CREPP-PLOEMEUR/le_Pot_Qui_pense/README.md

<!--# Le Pot Qui Pense -->
<!--+ 2019-2020 -->
<!--$ Jardinage-->
<!--$ Python -->
<!--% Un projet de plante connectée pour arroser automatiquement une plante. -->
# Pot Qui Pense

## Le projet 

Un projet de plante connectée pour arroser automatiquement une plante.

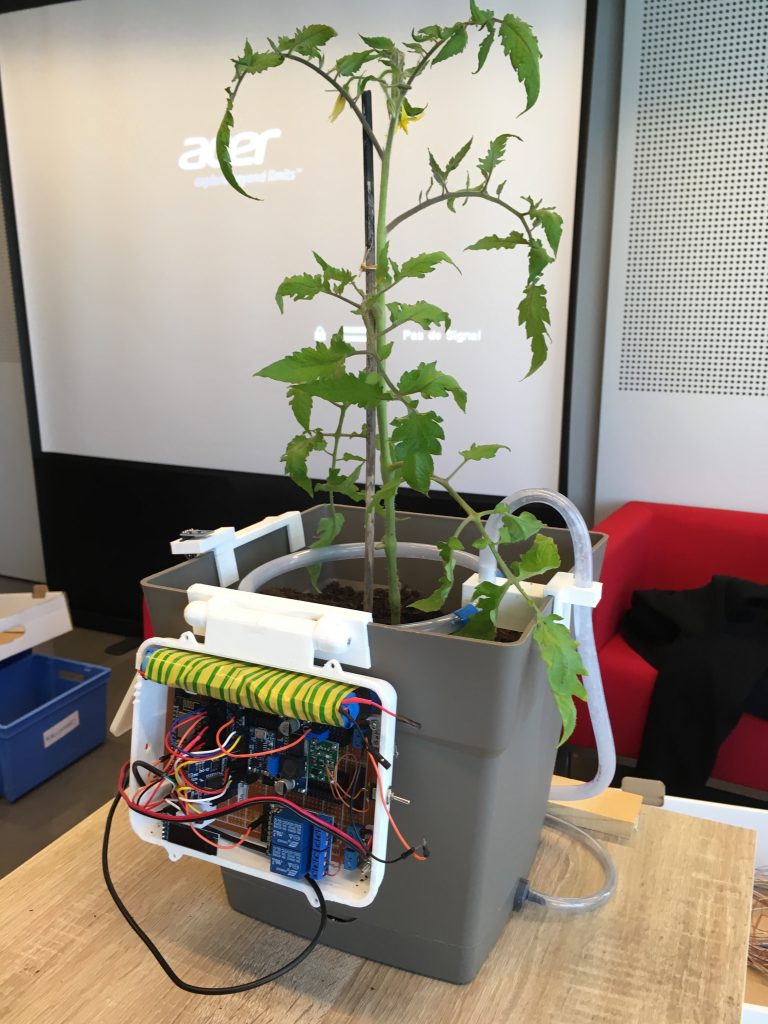
[picture p1: .img/pqp.jpg]
Pinout
