CREPP-PLOEMEUR/le_Pot_Qui_pense/Diagrammes/Essais PQP couvercle monté.odt

ESSAIS PQP ( couvercle monté – arrosage à 9h00 le matin )

L'objectif de ces essais est de :

- Sachant que l' écart entre U oled et U batteries est égal à 0.8, vérifier de 7h00 à 23h la valeur de la tension affichée,

- Mesurer à 23h00 la valeur de la tension aux bornes de la batterie,

- Vérifier à 7h00 la valeur de la tension affichée et mesurer la tension batteries,

- Voir au bout de combien de jours la batterie doit-être rechargée avec le chargeur intégré.

Date | Heure | Temp °C | Index capteur humidité | Uv affichée | Uv batterie | Observations
1er juillet | 8h00 | 20.9 | 10688 | 3.99v | 3,94v | Ciel bleu
| 9h00 | 20.7 | 8554 | 3.99v | 3,94v | Ciel voilé Arrosage 10 sec
| 13h00 | 24.9 | 8478 | 4.18v | | Remise en service après recharge batteries
| 14h00 | 25 | 8476 | 4.16v | | Soleil et nuages
| 15h00 | 24.7 | 8486 | 4.13v | | Soleil et nuages
| 16h00 | 25.6 | 8509 | 4.10v | | Nuageux
| 17h00 | 26.3 | 8561 | 4.11v | | Nuageux
| 18h00 | 25.5 | 8569 | 4.08v | | Ciel bleu
| 19h00 | 25.11 | 8570 | 4,08v | 4.00v | Ciel bleu
| 20h00 | 25.1 | 8576 | 4.07v | 3.99v | Ciel dégagé
| 21h00 | 24.8 | 8585 | 4.06v | 3.99v | Ciel dégagé
| 22h00 | 24.4 | 8598 | 4.05v | 3.98v | Nuit
| 23h00 | 23.9 | 8595 | 4.04v | 3.98v | Nuit
2 juillet | 8h00 | 19.7 | 8654 | 4.0v | 3.94v | Ciel bleu
| 9h00 | 20.4 | 8662 | 4.0v | 3.93v | Ciel bleu Arrosage 10 sec
| 10h00 | 21.2 | 8273 | 4.0v | 3.93v | Ciel bleu
| 11h00 | 21.3 | 8268 | 4.0v | 3.94v | Ciel bleu
| 12h00 | 22.2 | 8251 | 4.0v | 3.94v | Ciel bleu
| 13h00 | 22.1 | 8257 | 4.22v | 4.07v | Soleil
| 14h00 | 25.1 | 8274 | 4.27v | 4.12v | Soleil pleine exposition
| 16h00 | 31.5 | 8315 | 4.29v | 4.12v | Soleil pleine exposition

17H00 32.3 7934 4.14v 4.07v Rentré véranda ciel bleu

| 18h00 | 26.8 | 7941 | 4.13v | 4.06v | Implanté plant de tomates cerises
| 19h00 | 25.6 | 7947 | 4.12v | 4.06v | Ciel bleu
| 20h00 | 24.5 | 7947 | 4.10v | 4.05v | Ciel bleu
| 21h00 | 24.1 | 7950 | 4.10v | 4.03v | Sombre
| 22h00 | 24.1 | 7950 | 4.10v | 4.03v | Nuit
| 23h00 | 24.1 | 7965 | 4.09v | 4.03v | Nuit
3 juillet | 7h00 | 20.7 | 8012 | 4.05v | 3.99v | Ciel bleu
| 8h00 | 20.7 | 7995 | 4.05v | 3.99v | Ciel bleu
| 9h00 | 21.4 | 8025 | 4.05v | 3.98v | Ciel bleu arrosage 3 sec
| 10h00 | 21.4 | 7970 | 4.05v | 3.98v | Ciel bleu
| 11h00 | 21.1 | 7974 | 4.05 | 3.98v | Ciel bleu
| 12h00 | 22 | 7967 | 4.05v | 3.98v | Plein soleil
| 13h00 | 22.9 | 7993 | 4.27v | 4.10v | Plein soleil
| 14h00 | 26 | 8035 | 4.28v | 4.12v | Plein soleil
| 15h00 | 29.3 | 8057 | 4.29v | 4.14v | Plein soleil
| 16h00 | 29.6 | 8074 | 4.20v | 4.10v | Ciel bleu
| 17h00 | 28.7 | 8091 | 4.14v | 4.08v | Ciel bleu
| 18h00 | 27.2 | 8181 | 4.13v | 4.08v | Ciel bleu
| 19h00 | 26.7 | 8114 | 4.12v | 4.07v | Ciel légèrement couvert
| 23h00 | 24.9 | 8147 | 4.08v | 4.08v | Nuit

4 juillet | 7h00 | 21.4 | 8198 | 4.04v | 4.00v | Ciel bleu
| 8h00 | 22.3 | 8208 | 4.06v | 4.00v | « « « «
| 9n00 | 22.3 | 8212 | 4.06v | 4.00v | « « « « Arrosage 3 sec
| 10h00 | 22.4 | 8058 | 4.06v | 4.00v | « « « «
| 11h00 | 22.6 | 8053 | 4.06v | 4.00v | « « « «
| 12h00 | 22.8 | 8060 | 4.06v | 4.00v | « « « «
| 13h00 | 23.5 | 8070 | 4.29v | 4.11v | « « « « Plein soleil
| 14h00 | 27.4 | 8120 | 4.28v | 4.12v | « « « « « « « « « «
| 15h00 | 31.7 | 8143 | 4.29v | 4.15v | « « « « « « « « « «
| 16h00 | 30.6 | 8151 | 4.18v | 4.10v | Ciel bleu
| 17h00 | 30.6 | 8151 | 4.18v | 4.10v | « « «
| 18h00 | 28.1 | 8154 | 4.17v | 4.10v | « « «
| 19h00 | 27.9 | 8161 | 4.16v | 4.09v | « « «
| 20h00 | 27.2 | 8169 | 4.14v | 4.09v | « « «
| 21h00 | 27 | 8175 | 4.15v | 4.08v | « « «
| 22h00 | 26 | 8184 | 4.12v | 4.07v | « « «
| 23h00 | 24.5 | 8189 | 4.11v | 4.06v | nuit
5 juillet | 8h00 | 19.3 | 8229 | 4.06v | 4.02v | Ciel bleu
| 9h00 | 20 | 8236 | 4.09v | 4.02v | « « « « Arrosage 5 sec
| 10h00 | 22.2 | 7948 | 4.10v | 4.02v | « « « «
| 11h00 | 22.7 | 7954 | 4.10v | 4.03v | Ciel voilé
| 12h00 | 23.4 | 7961 | 4.10v | 4.03v | « « « «

| 13h00 | 24.1 | 7969 | 4.17v | 4.09v | Soleil
| 14h00 | 25.2 | 7988 | 4.19v | 4.05v | Soleil voilé
| 15h00 | 28.8 | 7995 | 4.13v | 4.05v | Légèrement couvert
| 16h00 | 26.1 | 7999 | 4.13v | 4.05v | « « « «
| 17h00 | 25.3 | 8004 | 4.11v | 4.05v | « « « «
| 18h00 | 25.2 | 8008 | 4.10 | 4.04v | « « « «
| 20h00 | 25.3 | 8017 | 4.09v | 4.03v | « « « «
| 21h00 | 25.3 | 8021 | 4.08v | 4.02v | « « « «
| 22h00 | 25.1 | 8025 | 4.07v | 4.02v | « « « «
| 23h00 | 24.7 | 8030 | 4.07v | 4.02v | Nuit
6 juillet | 8h00 | 21.3 | 8052 | 4.02v | 3.97v | Ciel bleu
| 9h00 | 21.7 | 8057 | 4.04v | 3.97v | « « « « Arrosage 8 sec
| 10h00 | 22.7 | 7948 | 4.04v | 3.97v | « « « «
| 13h00 | 24 | 7884 | 4.23v | 4.10v | Soleil
| 14h00 | 26.9 | 7882 | 4.28v | 4.12v | « « « «
| 15h00 | 29.8 | 7909 | 4.29v | 4.08v | Ciel bleu
| 16h00 | 29.2 | 7921 | 4.15v | 4.08v | « « « «
| 17h00 | 28.2 | 7928 | 4.15v | 4.07v | « « « «
| 18h00 | 27.3 | 7935 | 4.14v | 4.07v | « « « «
| 19h00 | 27.2 | 7942 | 4.13v | 4.06v | « « « «

| 20h00 | 26.7 | 7949 | 4.12v | 4.05v | « « « «
| 21h00 | 22.3 | 7955 | 4.12v | 4.05v | « « « «
| 22h00 | 25.9 | 7961 | 4.11v | 4.04v | Sombre
7 juillet | 8h00 | 22.2 | 8005 | 4.06v | 4v | Ciel bleu
| 9h00 | 22.5 | 8011 | 4.06v | 3.99v | « « « « Arrosage 8 sec
| 10h00 | 23.3 | 7799 | 4.06v | 3.99v | « « « «
| 14h00 | 26.1 | 7845 | 4.29v | 4.13v | Soleil
| 16h00 | 29.4 | 7888 | 4.15v | 4.08v | Ciel bleu
| 18h00 | 26.9 | 7905 | 4.14v | 4.07 | « « « «
| 20h00 | 26 | 7919 | 4.11v | 4.05v | « « « «
| 22h00 | 25.7 | 7930 | 4.09v | 4.04v | Sombre
8 juillet | 7h00 | 22.2 | 7966 | 4.05v | 4.0v
| 8h00 | 22 | 7971 | 4.04v | 4.0v
| 9h00 | 22.5 | 7977 | 4.06v | 4.0v
| 10h00 | 23.1 | 7774 | 4.07v | 4.0v
| 12h00 | 23.5 | 7780 | 4.06v | 4.0v
| 14h00 | 20.3 | 7819 | 4.29v | 4.12v
| 16h00 | 29.4 | 7860 | 4.16v | 4.08v
| 18h00 | 27.6 | 7887 | 4.13v | 4.07v
| 20h00 | 27.1 | 7913 | 4.12v | 4.06v
| 22h00 | 25.8 | 7935 | 4.10v | 4.05v

9 juillet | 7h00 | 22.4 | 7973 | 4.05v | 4.0v
| 9h00 | 22.8 | 8090 | 4.06v | 4.0v
| 12h00 | 23.6 | 7880 | 4.05v | 4.0v
| 15h00 | 31.8 | 7960 | 4.28v | 4.14v
| 18h00 | 27.4 | 8008 | 4.12v | 4.07v
| 22h00 | 25.6 | 8052 | 4.09v | 4.04v
10 juillet | 7h00 | 22 | 8108 | 4.03v | 3.99v
| 9h00 | 22.6 | 8126 | 4.06v | 3.99v
| 12h00 | 23.2 | 7882 | 4.04v | 4.00v
| 15h00 | 30.7 | 7955 | 4.27v | 4.07v
| 18h00 | 26.6 | 8003 | 4.12v | 4.05v
11 juillet | 7h00 | 22.8 | 8195 | 4.04v | 3.99v
| 9h00 | 22.8 | 8108 | 4.06v | 3.99v
| 10h00 | 23.2 | 7857 | 4.04v | 3.99v
| 12h00 | 23.8 | 7960 | 4.04v | 3.99v
| 15h00 | 29.9 | 7924 | 4.03v | 4.07v
| 22h00 | 23.7 | 8002 | 4.3v | 4.01v
| | | | 4.03v
12 juillet | 7h00 | 22.6 | 8047 | 3.99v | 3.97v
| 10h00 | 22.8 | 7837 | 4.04v | 3.98v
| 12h00 | 23.9 | 7842 | 4.04v | 3.98v
| 17h00 | 29.3 | 7921 | 4.09v | 4.05v

| 22H00 | 24.5 | 7966 | 4.05v | 4.01v
13 juillet | 8h00 | 21.3 | 8015 | 3.97v | 3.96v
| 9h00 | 21.8 | 8045 | 4.03v | 3.97v
| 11h00 | 22.7 | 7831 | 4.04v | 3.97v
| 14h00 | 25.4 | 7866 | 4.28v | 4.13v
| 16h00 | 29.1 | 7896 | 4.11v | 4.05v
| 18h00 | 26.3 | 7913 | 4.10v | 4.04v
| 20h00 | 25.5 | 7866 | 4.06v | 4.03v
| 22;00 | 25.1 | 7879 | 4.05v | 4.01v
14 juillet | 7h00 | 21.6 | 7918 | 4.04v | 3.97v
| 14h00 | 28.1 | 7769 | 4.27v | 4.14v
| 23h00 | 24.7 | 7863 | 4.03v | 3.98v
16 juillet | 8h00 | | 7897 | 3.97v | 3.98v
| 12h00 | | 7728 | 4.06v | 4.11v
| 23h00 | | 7828 | 4.06v | 4.05v
17 juillet
