CREPP-PLOEMEUR/le_Pot_Qui_pense/Diagrammes/Essais sur le DHT22.odt

ESP8266 – PROGRAMMES et CONSOLE WEBERPL

PRINCIPE

PREMIÈRE PARTIE

1°- CONSOLE Weberpl:

Sert à l'écriture d'un programme par exemple « Faire clignoter la diode de l'ESP8266 » en suivant les différentes étapes du tuto d' Yvon et validation de ce programme.

2°- GEANY éditeur de texte:

Écrire le programme précédent en micropython dans Geany, lui donner un nom « potsol2.py » et le sauvegarder dans un dossier Py_PQT.

1 import machine

2 import time

3

4 led = machine.Pin (2, machine.Pin.OUT)

5

6 def toggle (p) :

7 p.value (not p.value())

8

9 def main() :

10 while True :

11 toggle(led)

12 time.sleep_ms (500)

3°- EXÉCUTION d'un fichier .py :

Se connecter sur l'ESP8266 et entrer le password : crepp

Dans la partie supérieure droite de la console dans « Send a file » cliquer sur « Parcourir » et dans la fenêtre Py_PQP, choisir et ouvrir « potsol2.py » par ex.

Cliquer sur « Send to device » , en bas de la fenêtre s'affiche « Sent potsol2.py. 181 bytes »

Exécuter le programme :

>>> import potsol2

>>> potsol2.main()

La diode clignote. CQFD

DEUXIÈME PARTIE

ESSAIS avec un DHT22

après avoir tenu compte des remarques d' Yvon au sujet de la perte de liaison wifi avec l'ESP8266

1°- CONSOLE :

>>> import dht

>>> import machine

>>> d=dht.DHT22(machine.Pin(12)) # GPIO 12 au lieu de GPIO15 ( Yvon )

>>> d.measure()

>>> d.temperature()

20

>>> d.humidity()

55

Le programme est validé après avoir, par 3 fois, mis hors service et en service l'ESP8266 sans perte de liaison wifi

2°- GEANY :

J'ai écrit ce programme suivant conçu par Florian :

1 import dht

2 import machine.Pin

3

4 d=dht.DHT22(machine.Pin(12))

5

6 def main() :

7 d.measure()

8 print (d.temperature())

9 print (d.humidity())

J'ai enregistré ce programme dans un fichier « PQPcapteurDHT11.py » et sauvegardé dans le dossier Py_PQP.

3°- EXÉCUTION du programme DHT11 :

J'ai procédé à l'importation dans l'ESP8266 du fichier « PQPcapteurDHT11.py » et procédé à la manip suivante dans la console :

>>> import PQPcapteurDHT22

>>> PQPcapteurDHT11.main()

20

48

>>>

=-=-=-=-=-=-=
