CREPP-PLOEMEUR/le_Pot_Qui_pense/Diagrammes/PQP essais charge-décharge batteries.odt

PQP ESSAIS CHARGE et DÉCHARGE BATTERIES

Dates | Heure | U bat. | U oled | U pan sol | Index | Observations
14/06/2019 | 14h
