CREPP-PLOEMEUR/le_Pot_Qui_pense/Divers/Essais d'arrosage et du capt. d'humidité Tr1.odt

ESSAIS « POT qui PENSE »

1°- ARROSAGE toutes les heures :

Heure | Tension affichée | Tension mesurée | Δ= | Observations
10h27
11h00 | 4.17v
12h00 | 4.16v
13h00 | 4.25v | 4.15v | 0.10v
14h00 | 4.27v | 4.17v | 0.10v | Exposition plein soleil
15h00 | 4.27v
16h00 | 4.20v
17h00 | 4.20v | 4.10v | 0.10v | Fin de l'exposition plein soleil
18h00 | 4.19v | | | Plus de charge – diode rouge éteinte
19h00 | 4.18v
20h00 | 4.17v | 4.09v | 0.08v
21h00 | 4.16v | 4.08v | 0.08v
22h00 | 4.15v | 4.07v | 0.08v | Pas de mesure d'humidité !!

Fonctionnement arrosage ttes les heures normal. ( sleeptime=0 dans 'pqp_config.py' )

Ordre des opérations : 1- relais activé 5sec ⇒ arrosage

2- affichage sur Oled – Température puis Tension batteries.

2°- ESSAIS capteur d' humidité. - hors PQP :

Principe : Dans un pot sur soucoupe on met du terreau qui a été séché au soleil puis, après avoir enterré le capteur et effectué une première mesure, on arrose jusqu'à ce que l'eau apparaisse dans la soucoupe ( saturation en eau ).

2-1- mesure terreau sec : 13.888

2-2- mesure terreau saturé en eau : 13h15 ⇒ 7.409

14h15 ⇒ 7.450

15h15 ⇒ 7.487 L'eau dans la soucoupe a disparu

16h15 ⇒ 7.519 - id -

3°- ESSAIS capteur humidité – effectués sur le PQP : La fonction arrosage est supprimée.

3-1- Pour réaliser cet essai, la fonction arrosage est supprimée mais il faut savoir qu' auparavant il y a eu 8 arrosages du fait de la mise hors et en service de l'ESP.

3-2- Le capteur d'humidité est enterré dans le PQP, pour pouvoir disposer de l'accès wifi à l'ESP, on a réglé le sleeptime à -1 dans 'pqp_config.py'.

Date | Heure | Valeur capteur | Observations
18 Mai | 20h00 | 8185
19 Mai | 8h30 | 8285
20 Mai | 8h30 | 8311
20 Mai | 19h30 | 8508
21 Mai | 8h00 | 8555

REMARQUES :

Il est recommandé d'arroser les plantes le matin et non comme je l'ai fait constamment de 11h00 à 22h00 pour les essais avec une période en plein soleil et derrière une baie vitrée !

La plante a un peu souffert.

Afin de poursuivre les essais plus précis, il faudrait dans 'pqp_config.py' déclencher par exemple un arrosage toutes les heures de 6h00 à 9h00 avec un temps de fonctionnement pompe de 10 sec.

Le Jeudi 23 Mai

4°- ARROSAGE toutes les 15 mn :

Temps de fonctionnement de la pompe 10 sec

| Tension affichée | Tension mesurée | Δ= | Capteur humidité | Observations
Départ 19h00 | 4.13 v | 4.01 v | 0.12 | 10 025 | 5 fonctionnement de pompe
Fin 20h00 | 4.12 v | 4.0 v | 0.12 | 9 439 | 500ml d'eau en 1 heure

10 sec ⇒ ~ 100 ml d'eau

Le Vendredi 24 Mai

5°- ARROSAGE toutes les 15mn :

Temps de fonctionnement de la pompe 5 sec

| Tension affichée | Tension mesurée | Δ= | Capteur Observations humidité
Départ 18h40 | 4.13 v | 4.04 v | 0.09 | 9 076 17 fonctionnement de pompe
Fin 22h40 | 4.10 v | 4.02 v | 0.08 | 8 199 850 ml d'eau en 4 heures

5 sec ⇒ ~ 50 ml d'eau

Le Samedi 25 Mai

6°- ARROSAGE toutes les 30 mn :

Temps de fonctionnement de la pompe 5 sec

Le capteur a été enfoncé plus profondément dans la terre

| Tension affichée | Tension mesurée | Δ= | Capteur humidité | Observations
Départ 8h30 | 4.09 v | 3.97 v | 0.12 | 8 099 | 13 fonctionnement de pompe
Fin
