CREPP-PLOEMEUR/le_Pot_Qui_pense/Divers/Essais d'arrosage et du capteur d' humidité Tr2.odt

ESSAIS d' ARROSAGE et du CAPTEUR d' HUMIDITÉ

Préalables : - Le capteur capacitif d' humidité a été enfoui en pleine terre,

- Les fichiers « pqp_horloge.py » et « pqp_task.py » ont été modifiés afin :

* D' afficher sur l' afficheur Oled les indications du capteur d' humidité en plus de la température et de la tension batteries déjà affichées.

* De faire déclencher la pompe toutes les 24h à 9h du matin

- Dans le fichier « pqp_config.py » « sleeptime= 0 » afin que toutes les heures il soit effectuées un relevé des valeurs du capteur d' humidité et de la tension batterie, affichées sur l'oled.

- Le temps de fonctionnement de la pompe a été réglé à 10 sec.

Date | Heure | Capt. humidité | Tension affichée | Tension mesurée | Diode chargeur | Tension panneau solaire | Observations + ∆ entre V affichée et V batterie
25/05/19 | 17h00 | 8316 | 4.04v | 3.96v | R | 4.14v | ∆=0.08v
| 18h00 | 8353 | 4.04v | 3.96v | R | 4.00v | ∆=0.08v
| 19h00 | 8365 | 4.03v | 3.95v | Éteinte | Non mes | ∆=0.08v
| 20h00 | 8388 | 4.03v | 3.95v | Éteinte | Non mes | ∆=0.08v
| 21h00 | 8390 | 4.02v | 3.92v | Éteinte | Non mes | ∆=0.10v
| 22h00 | 8403 | 4.02v | 3.92v | Éteinte | Non mes | ∆=0.10v
26/05/19 | 7h00 | 8397 | 3.97v | 3.89v | Éteinte | Non mes | ∆=0.08v
| 8h00 | 8412 | 3.97v | 3.89v | R | 3.96v | ∆=0.08v
| 9h00 | 7932 | 3.96v | 3.88v | R | 3.98v | Fonctionnement pompe 10 sec ∆=0.08v
| 10h00 | 8144 | 3.96v | 3.88v | R | 4.14v | ∆=0.08v
| 11h00 | 8155 | 3.96v | 3.89v | R | 3.97v | ∆=0.07v
| 12h00 | 8321 | 3.95v | 3.89v | R | 3.97v | ∆=0.07v
| 13h00 | 8323 | 3.94v | 3.88v | R | 4.14v | ∆=0.06v
