CREPP-PLOEMEUR/le_Pot_Qui_pense/Diagrammes/potConnectéSchémaElecRev5.pdf

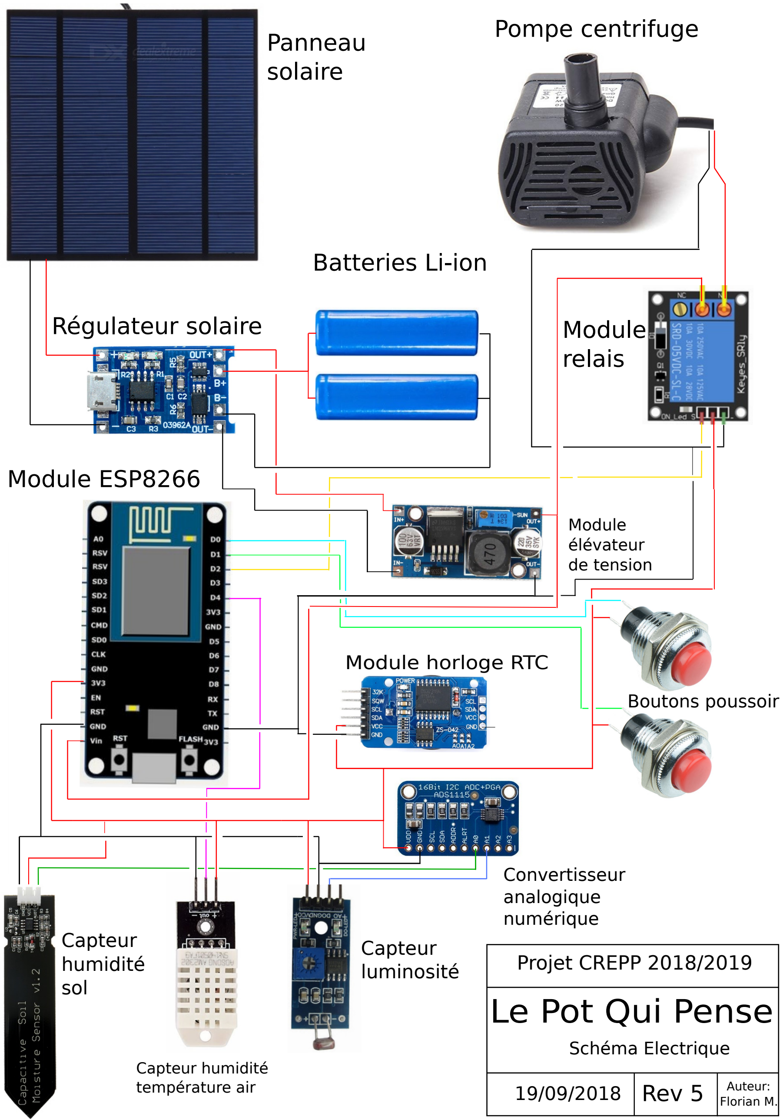
[picture p19: figure]
Le Pot Qui Pense; Rev 5; Projet CREPP 2018/2019; Schéma Electrique; Auteur: Florian M.; Panneau solaire; Régulateur solaire; Batteries Li-ion; Module ESP8266; Capteur humidité sol; Capteur humidité température air; Capteur luminosité; Module relais; Module élévateur de tension; Pompe centrifuge; Module horloge RTC; Convertisseur analogique numérique; Boutons poussoir
