CREPP-PLOEMEUR/le_Pot_Qui_pense/Circuits_electronique/Exemple de câblage circuits 5v et 9v.PDF

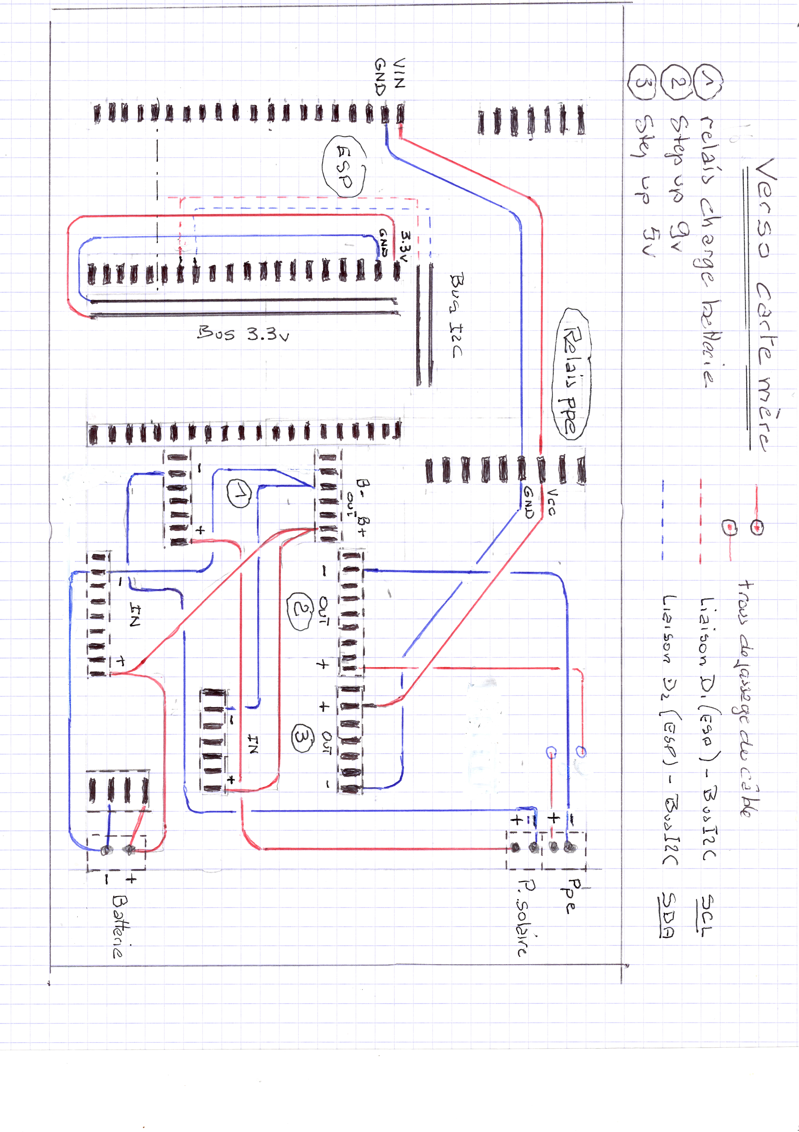
[picture p20: page 1]
