CREPP-PLOEMEUR/le_Pot_Qui_pense/Divers/Implatation_composants.pdf

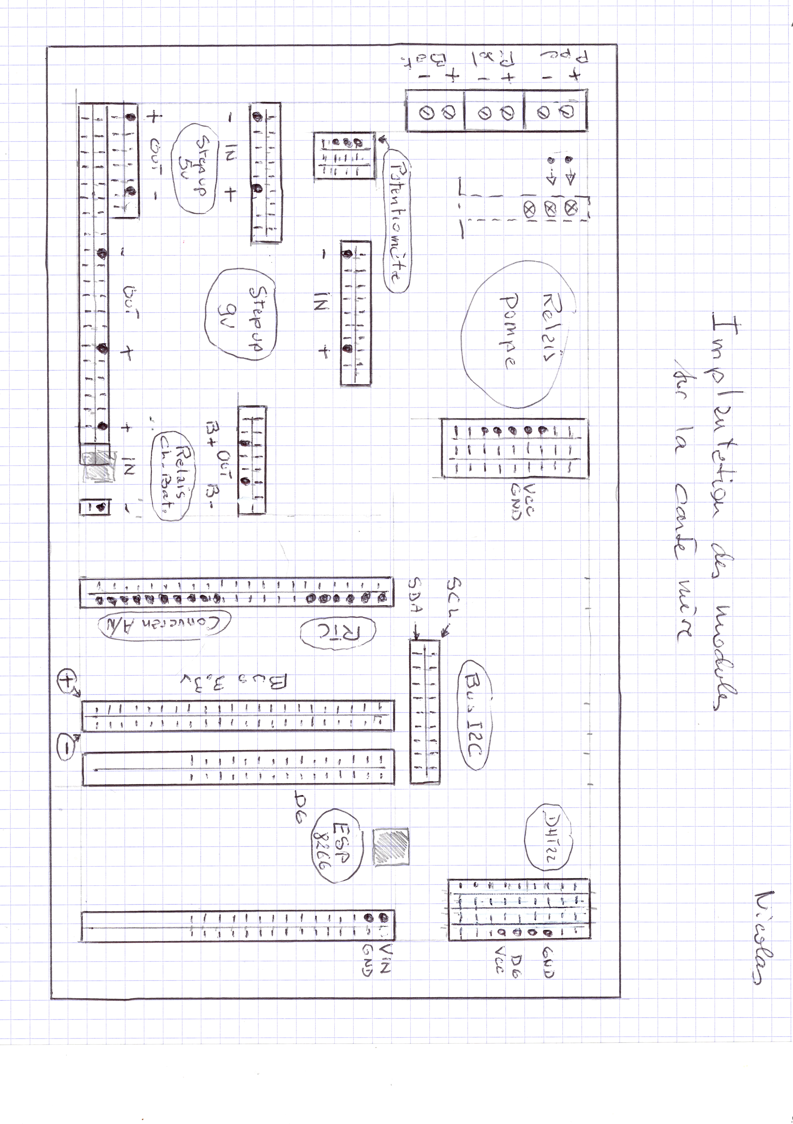
[picture p21: page 1]
