CREPP-PLOEMEUR/le_Pot_Qui_pense/Circuits_electronique/181210 arri├иre Esp8266.jpg

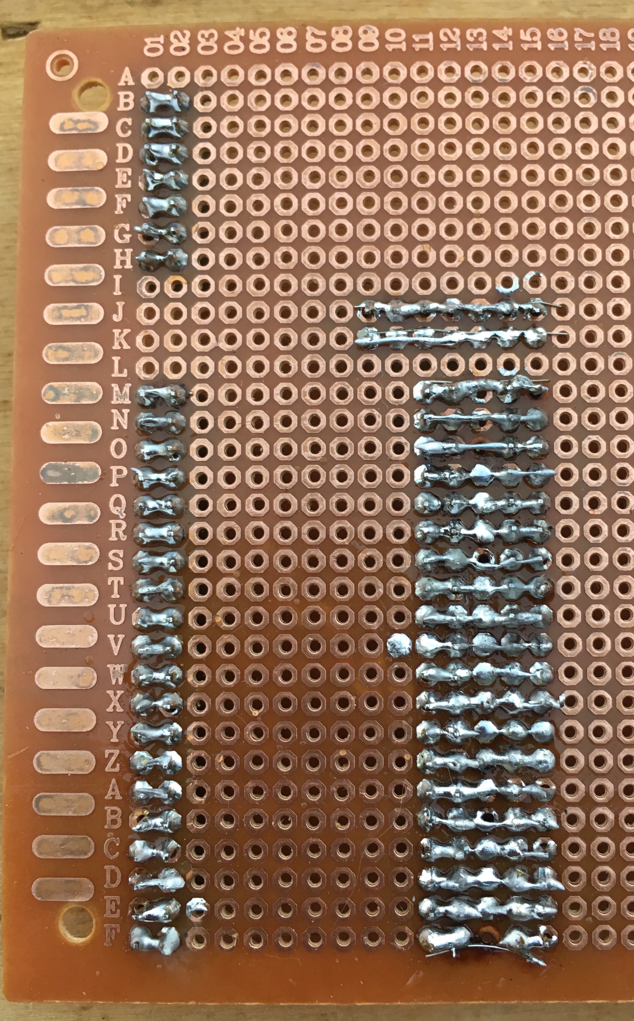
Circuits_electronique/181210 arri├иre Esp8266.jpg
