CREPP-PLOEMEUR/le_Pot_Qui_pense/Circuits_electronique/181210 arri├иre vue g├йn├йrale.jpg

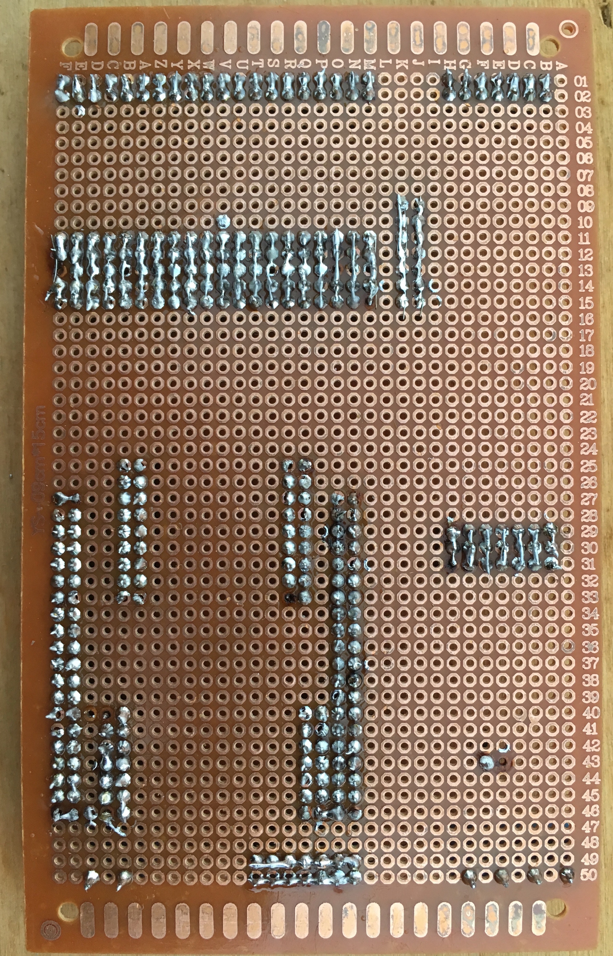
Circuits_electronique/181210 arri├иre vue g├йn├йrale.jpg
