CREPP-PLOEMEUR/le_Pot_Qui_pense/Circuits_electronique/181210 Arri├иre ├йlectrique, en noir les ponts ├а souder.jpg

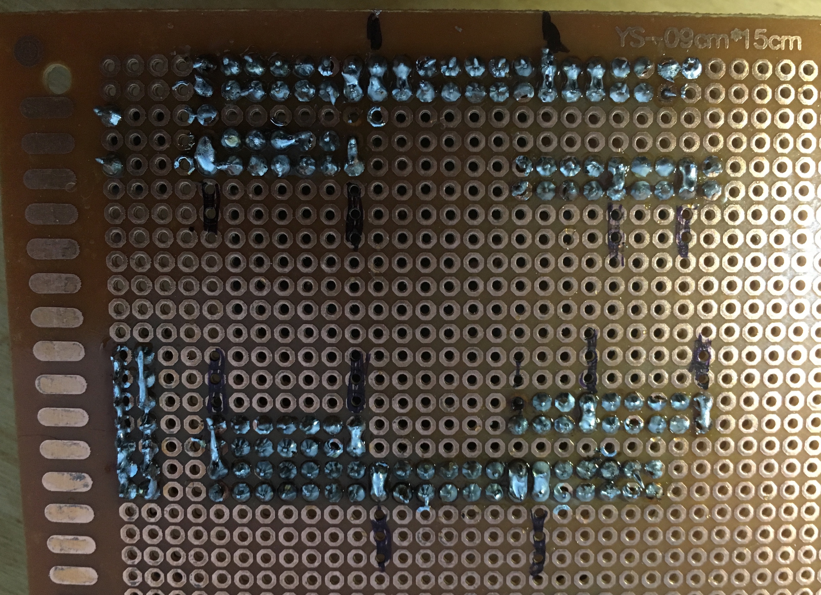
Circuits_electronique/181210 Arri├иre ├йlectrique, en noir les ponts ├а souder.jpg
