CREPP-PLOEMEUR/le_Pot_Qui_pense/Circuits_electronique/181210 en panne.jpg

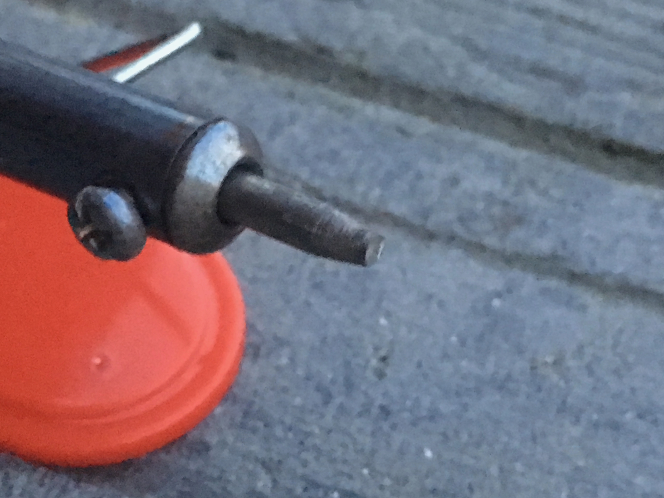
Circuits_electronique/181210 en panne.jpg
