CREPP-PLOEMEUR/le_Pot_Qui_pense/Circuits_electronique/181210 module modifi├й.jpg

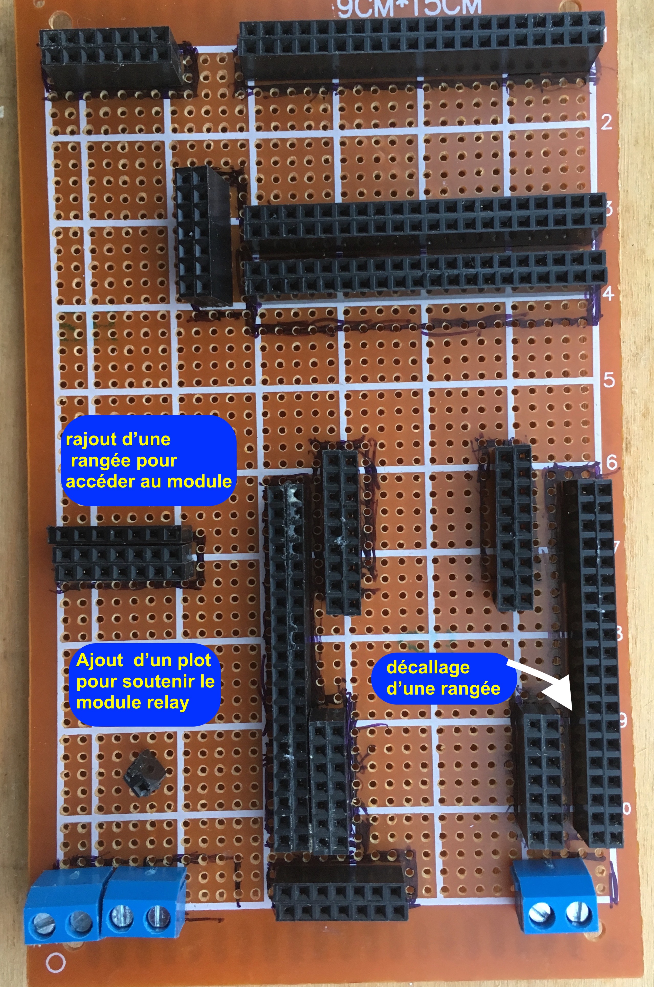
Circuits_electronique/181210 module modifi├й.jpg
