CREPP-PLOEMEUR/le_Pot_Qui_pense/Circuits_electronique/181210 modules.jpg

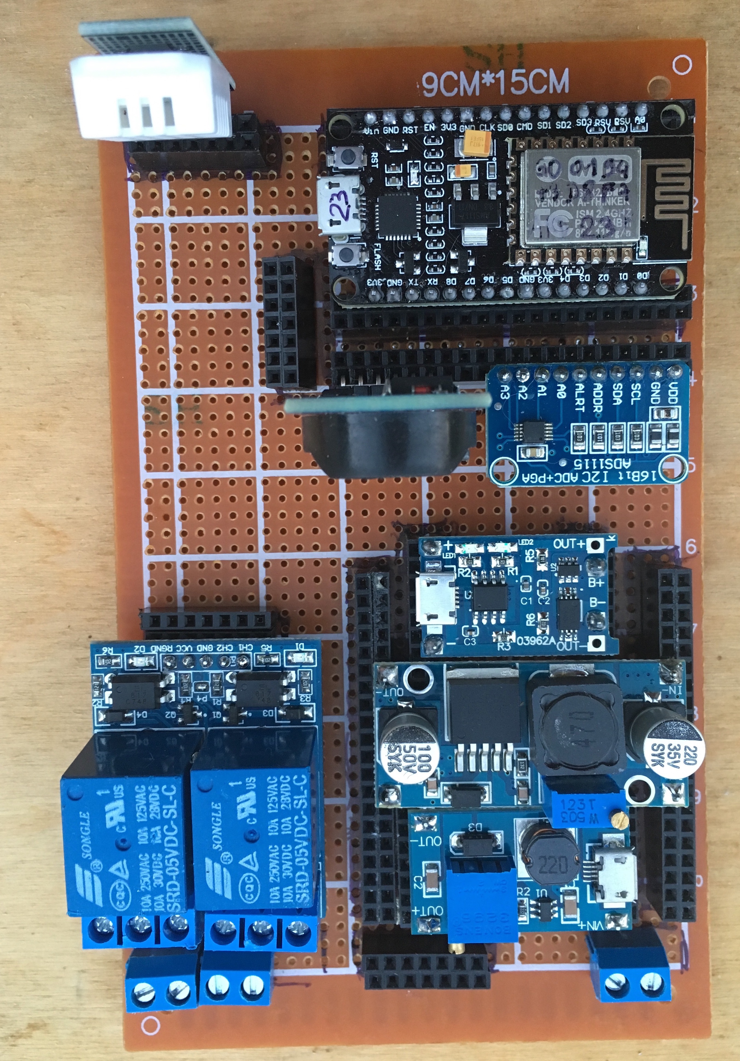
Circuits_electronique/181210 modules.jpg
