CREPP-PLOEMEUR/le_Pot_Qui_pense/Circuits_electronique/carte mère équipée.jpg

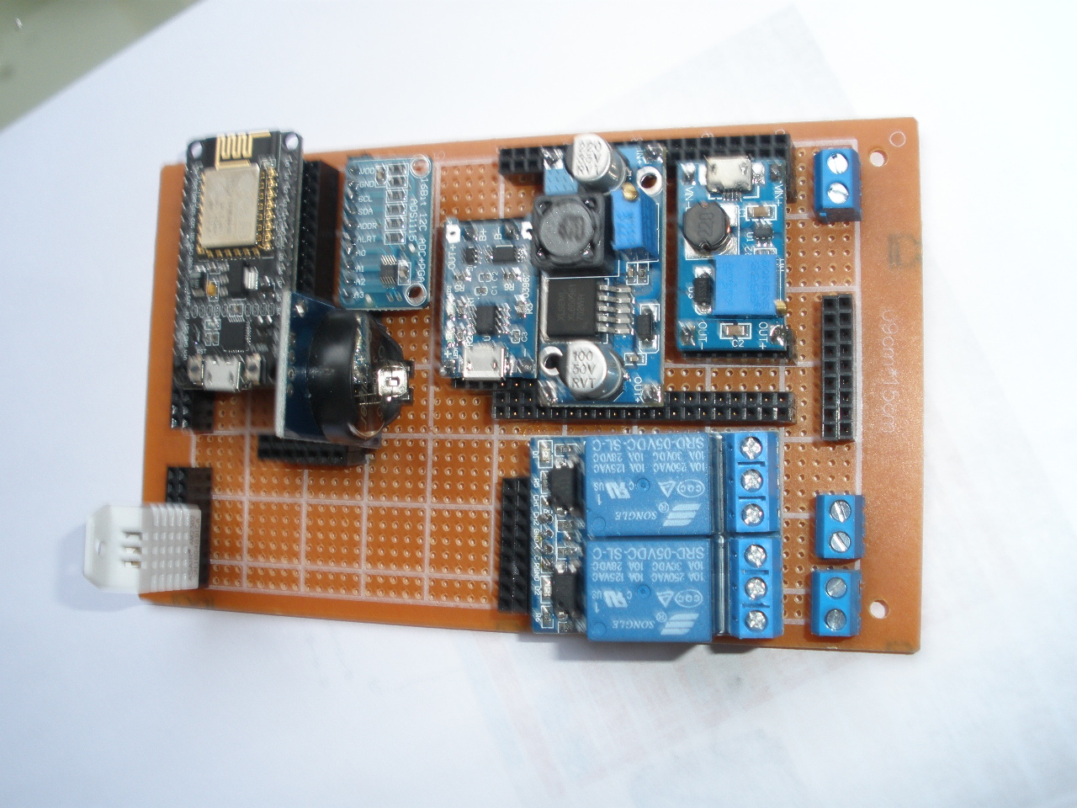
Circuits_electronique/carte mère équipée.jpg
