CREPP-PLOEMEUR/le_Pot_Qui_pense/Circuits_electronique/Circuit imprimé pot20.jpg

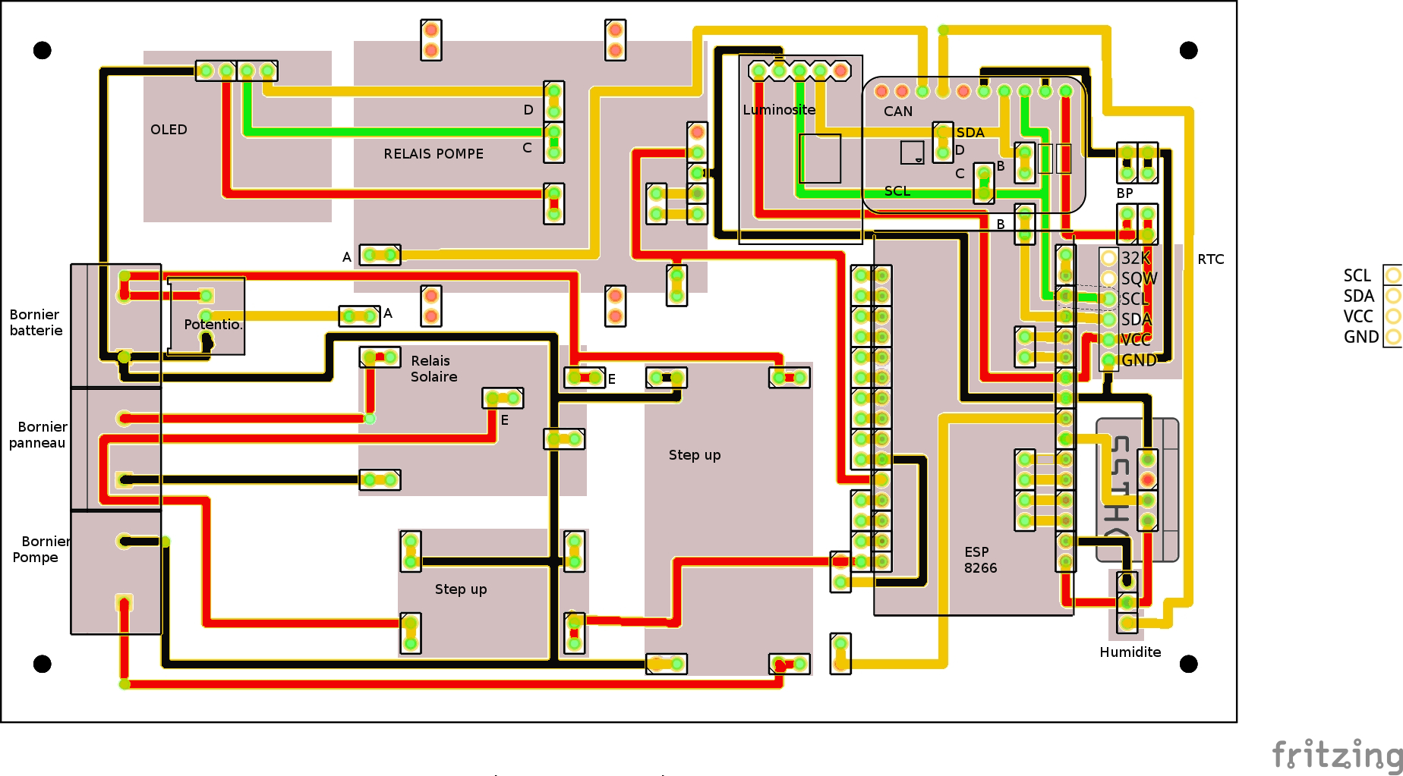
Circuits_electronique/Circuit imprimé pot20.jpg
