CREPP-PLOEMEUR/le_Pot_Qui_pense/Circuits_electronique/implantation carte mère 3.jpg

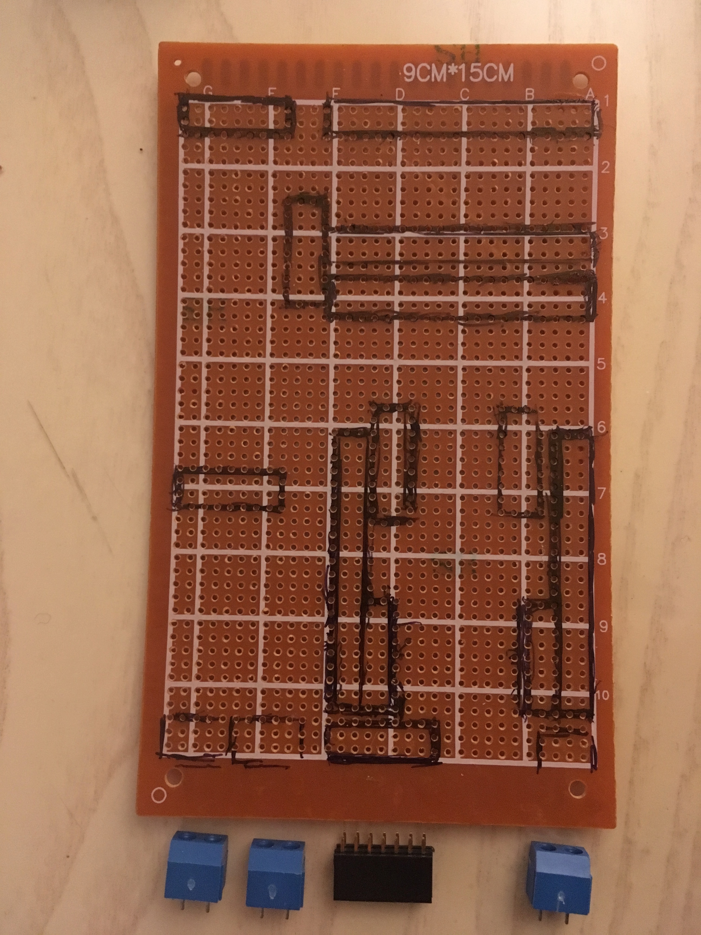
Circuits_electronique/implantation carte mère 3.jpg
