CREPP-PLOEMEUR/le_Pot_Qui_pense/Divers/Carte_principale.jpg

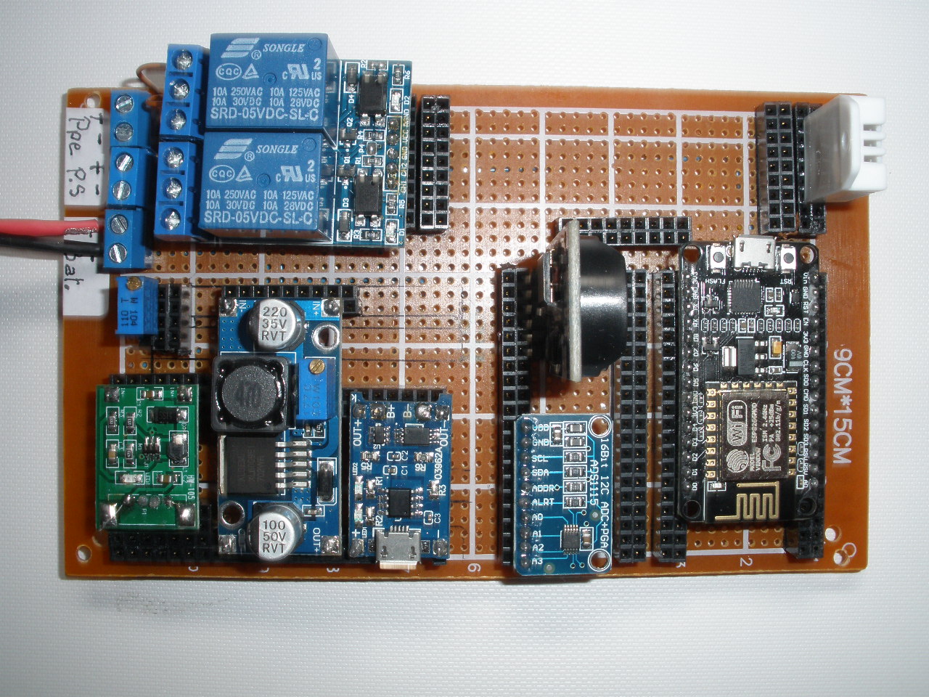
Divers/Carte_principale.jpg
