CREPP-PLOEMEUR/le_Pot_Qui_pense/Fichiers STL/PotPV.png

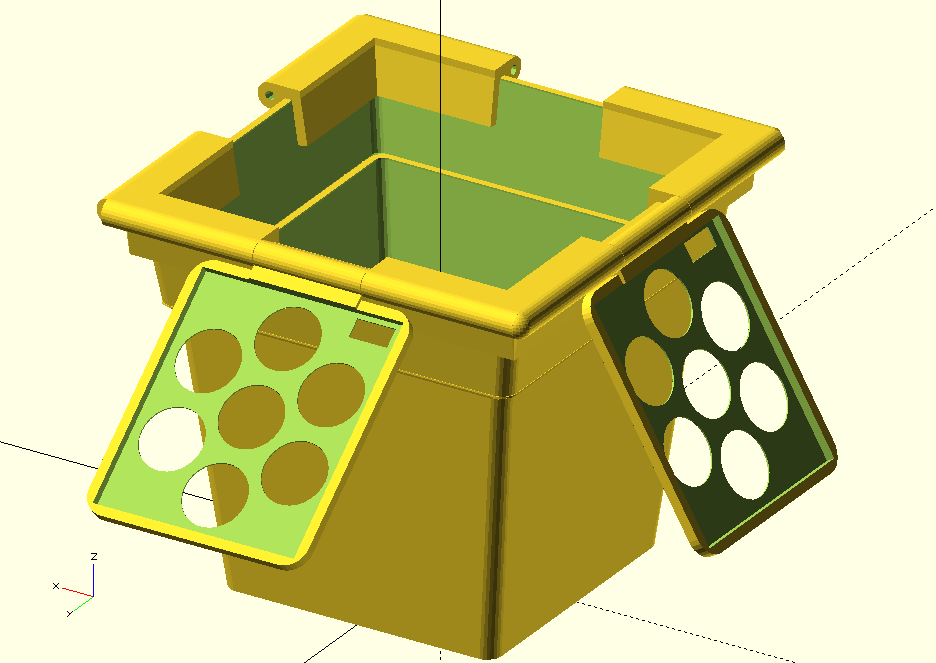
Fichiers STL/PotPV.png
