CREPP-PLOEMEUR/le_Pot_Qui_pense/Fichiers STL/PotSolaire.png

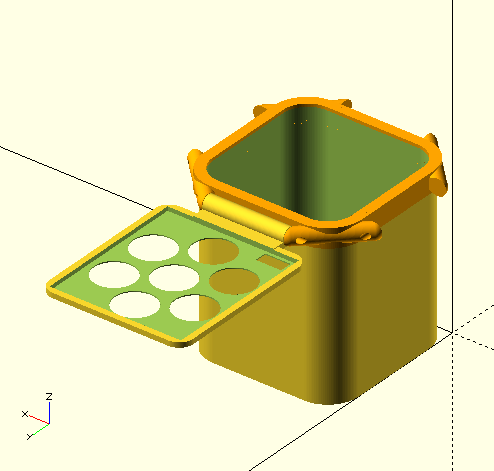
Fichiers STL/PotSolaire.png
