CREPP-PLOEMEUR/le_Pot_Qui_pense/Fichiers STL/Pqp_BoiteCadre.png

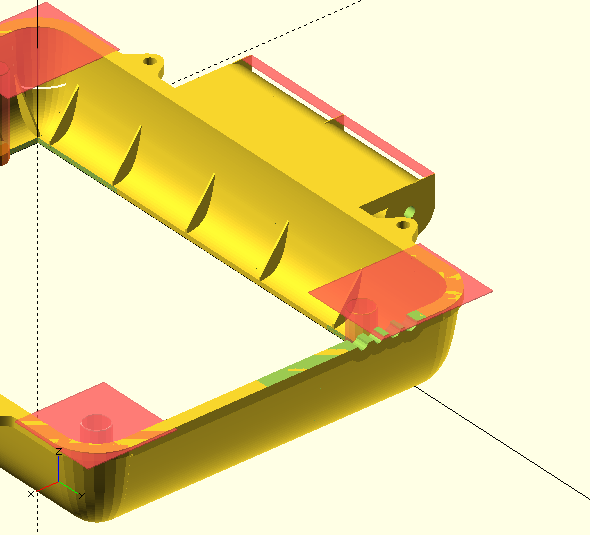
Fichiers STL/Pqp_BoiteCadre.png
