CREPP-PLOEMEUR/le_Pot_Qui_pense/Images/2 panSol sur PQP.JPG

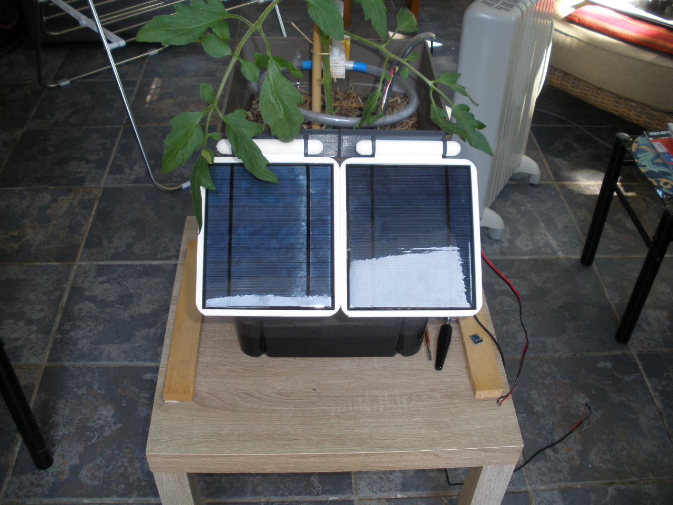
Images/2 panSol sur PQP.JPG
