CREPP-PLOEMEUR/le_Pot_Qui_pense/Images/181210 poste de travail dans le jardin.jpg

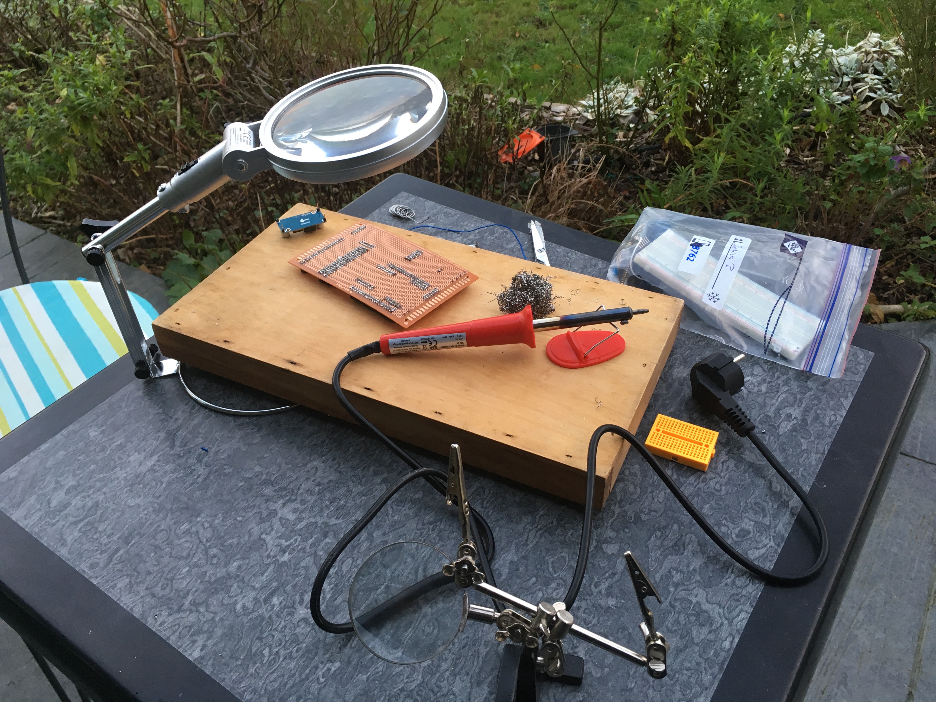
Images/181210 poste de travail dans le jardin.jpg
