CREPP-PLOEMEUR/le_Pot_Qui_pense/Images/181211 PQP_ElecnCable_3.jpg

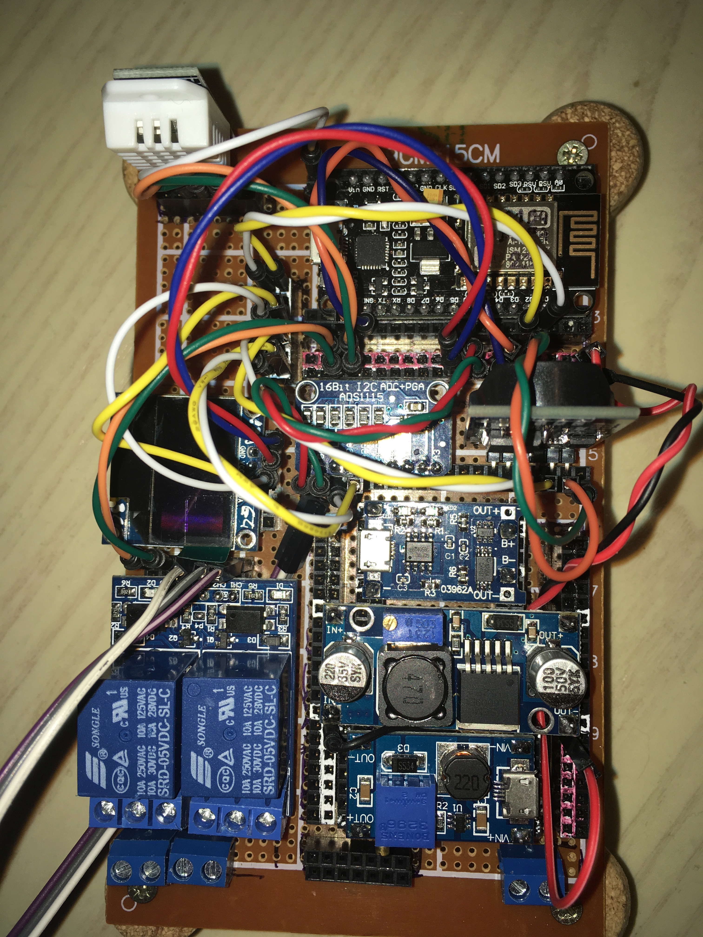
Images/181211 PQP_ElecnCable_3.jpg
