CREPP-PLOEMEUR/le_Pot_Qui_pense/Images/181211 PQP_ElecnCable_6.jpg

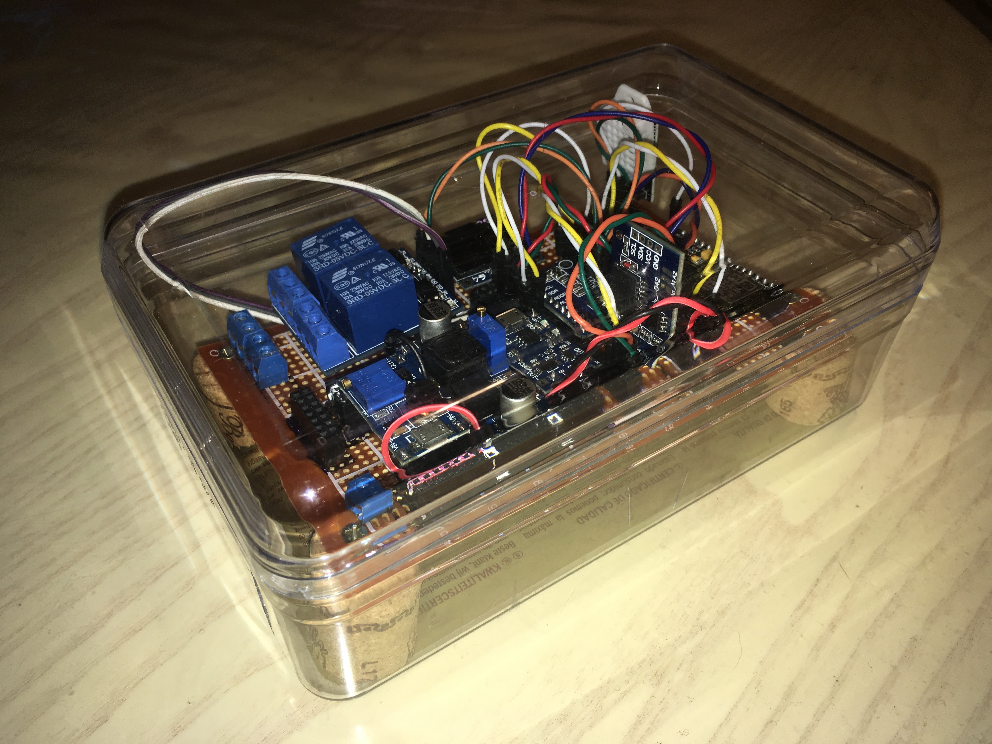
Images/181211 PQP_ElecnCable_6.jpg
