CREPP-PLOEMEUR/le_Pot_Qui_pense/Images/Couvercle du boîtier PQP.JPG

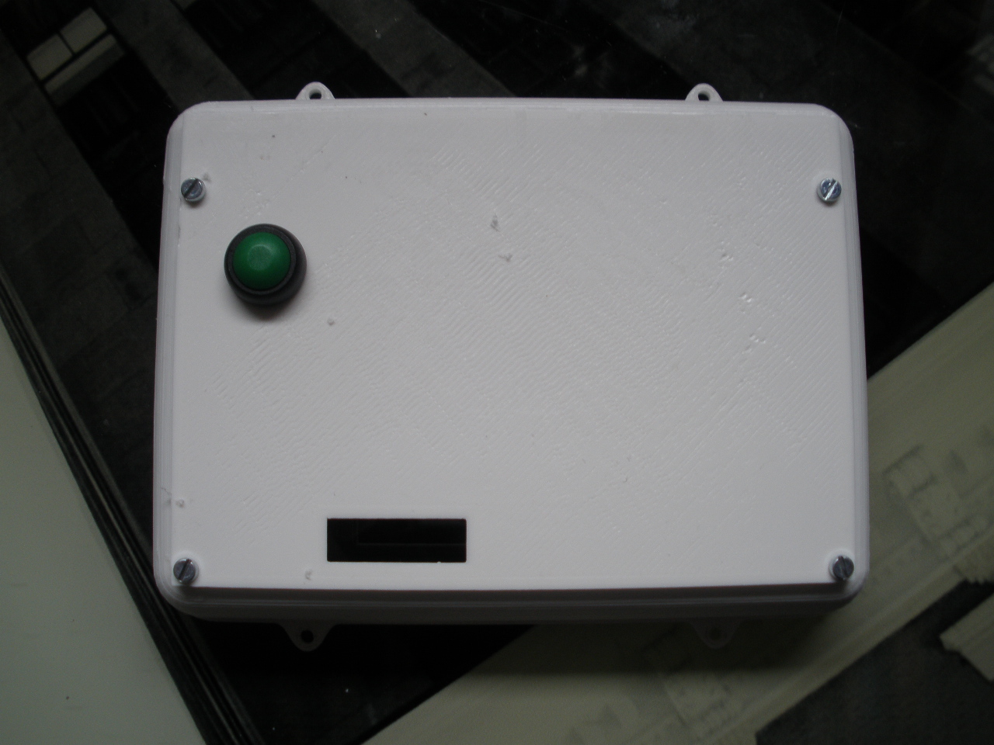
Images/Couvercle du boîtier PQP.JPG
