CREPP-PLOEMEUR/le_Pot_Qui_pense/Images/P5230002.JPG

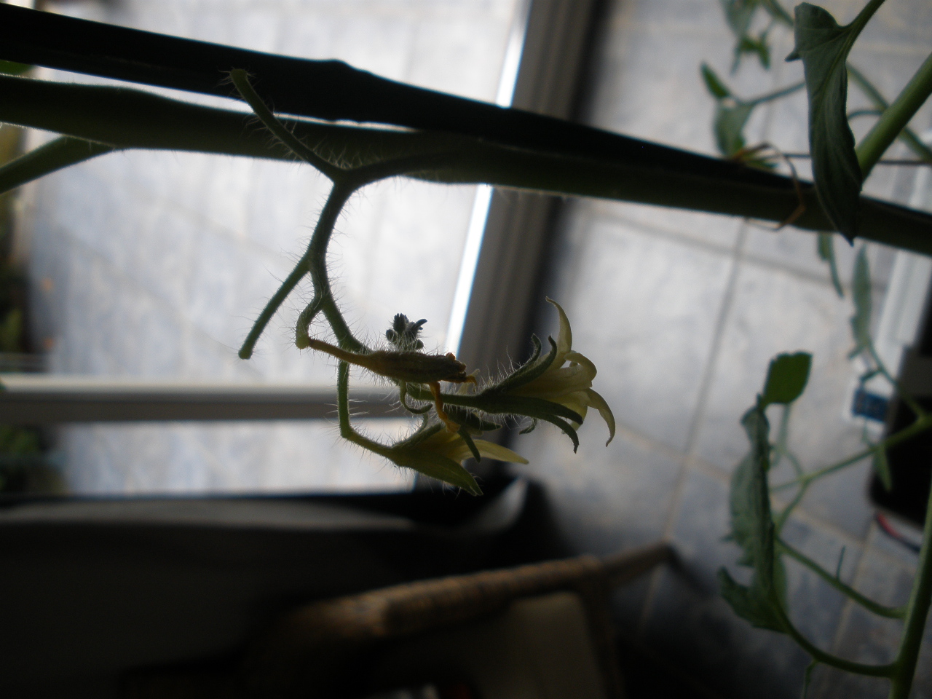
Images/P5230002.JPG
