CREPP-PLOEMEUR/le_Pot_Qui_pense/Images/Ppq Boitier électronique.jpg

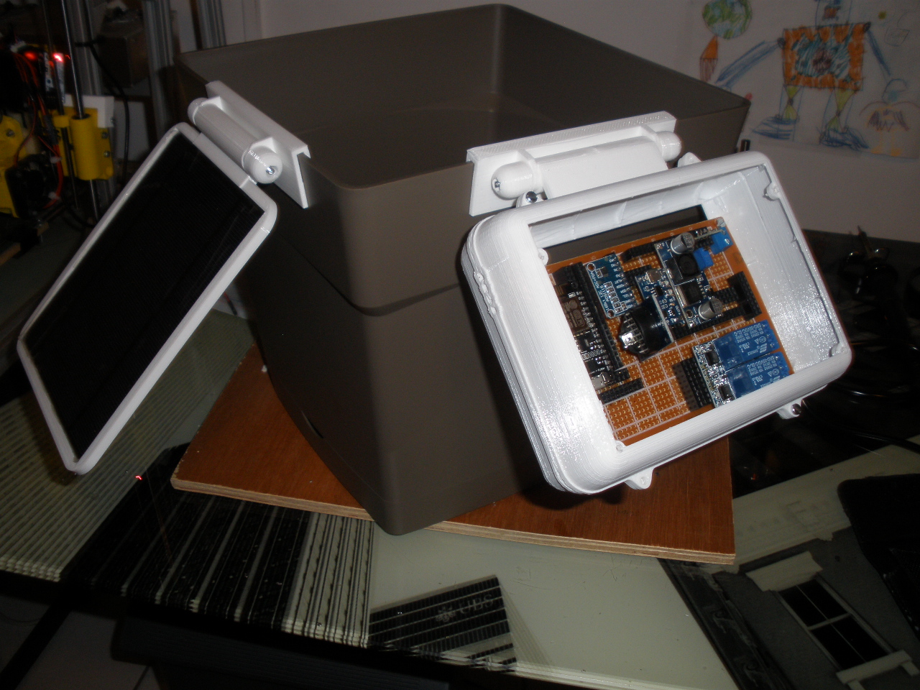
Images/Ppq Boitier électronique.jpg
