CREPP-PLOEMEUR/le_Pot_Qui_pense/Images/Pqp booîtier électronique 2.jpg

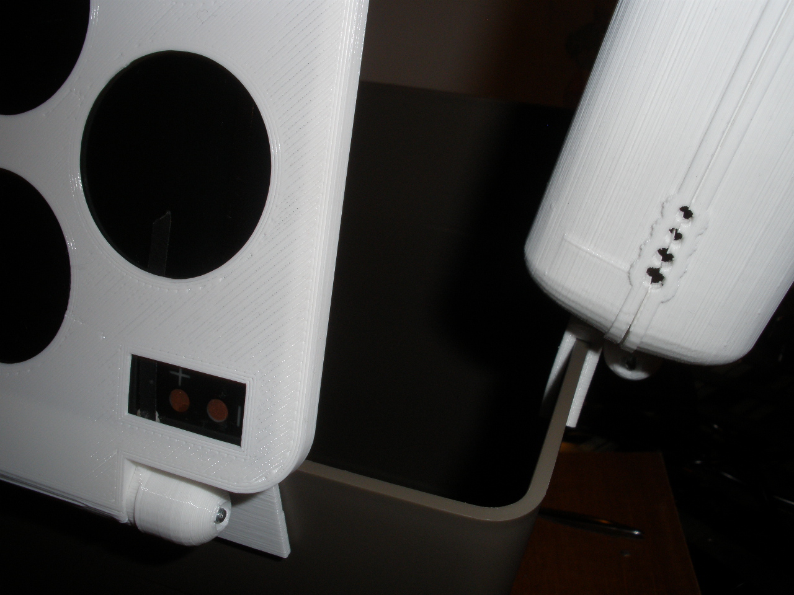
Images/Pqp booîtier électronique 2.jpg
