CREPP-PLOEMEUR/le_Pot_Qui_pense/Images/PQP en cours.jpg

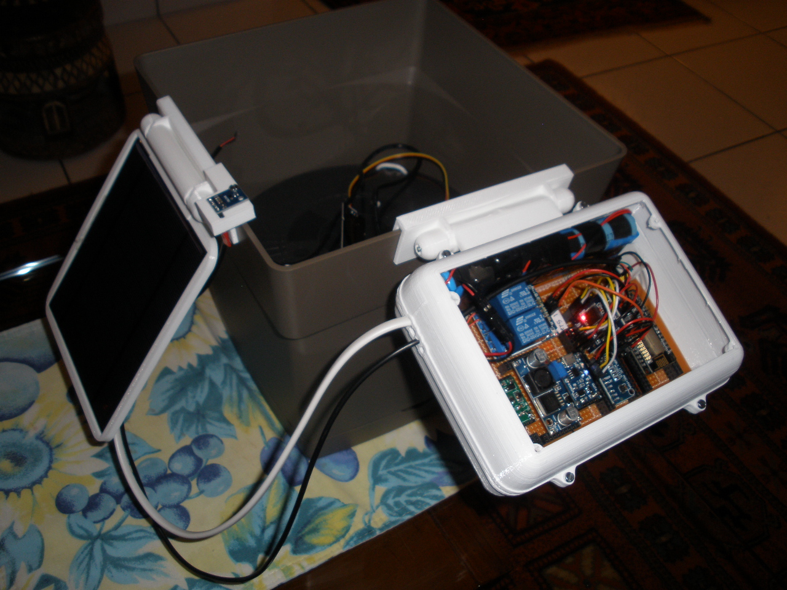
Images/PQP en cours.jpg
