CREPP-PLOEMEUR/le_Pot_Qui_pense/Images/PQP vue1.JPG

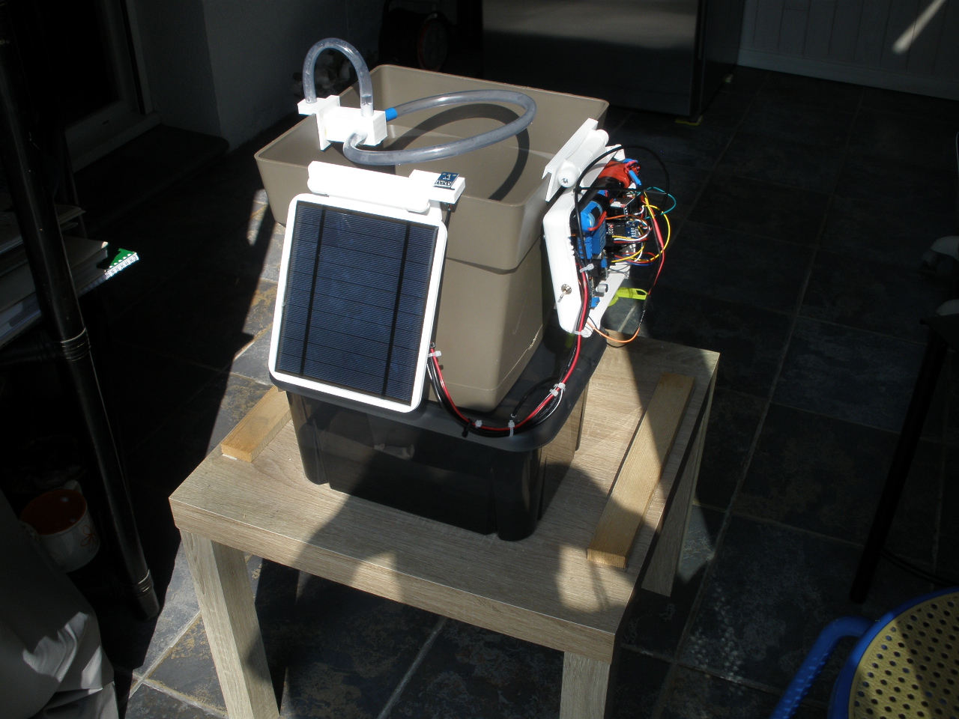
Images/PQP vue1.JPG
