CREPP-PLOEMEUR/le_Pot_Qui_pense/Images/PQP vue2.JPG

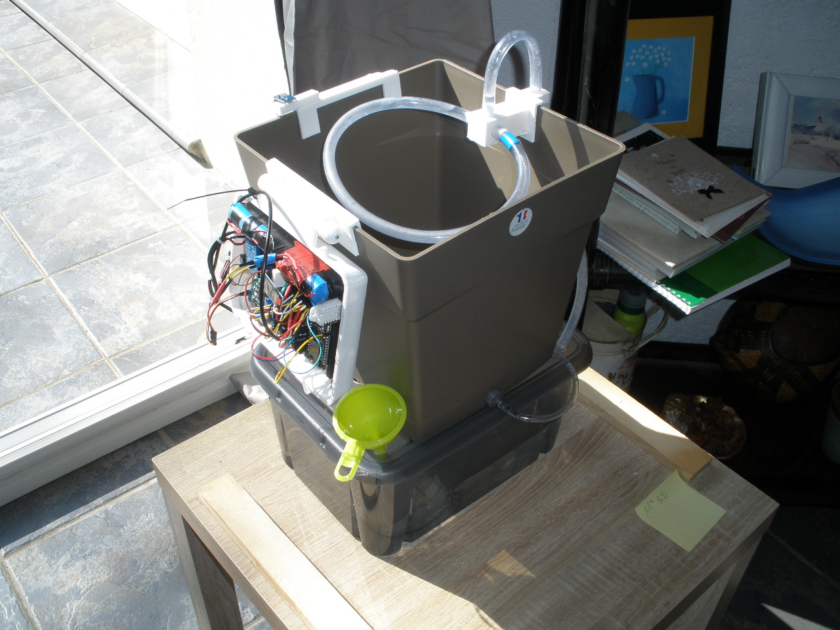
Images/PQP vue2.JPG
