CREPP-PLOEMEUR/le_Pot_Qui_pense/Images/PQP vue3.JPG

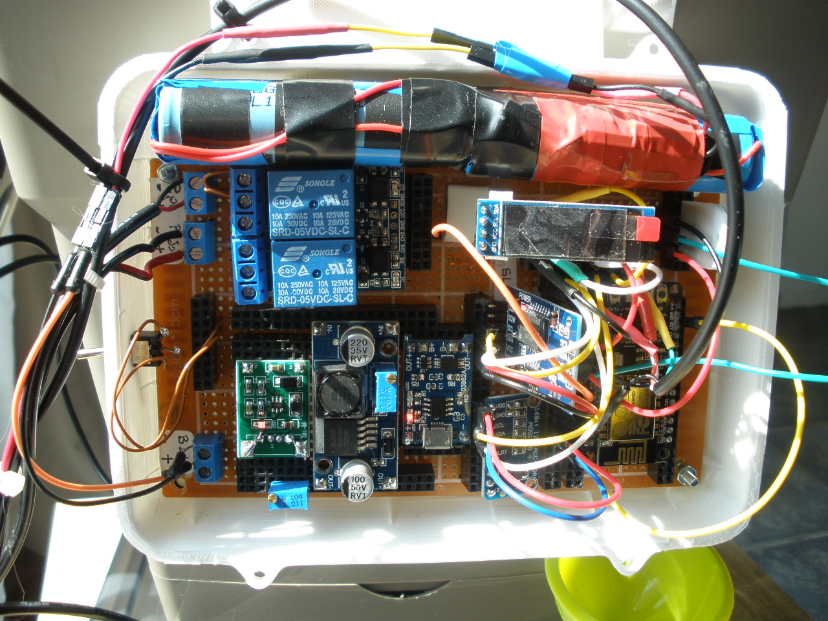
Images/PQP vue3.JPG
