CREPP-PLOEMEUR/le_Pot_Qui_pense/Images/PQP vue4.JPG

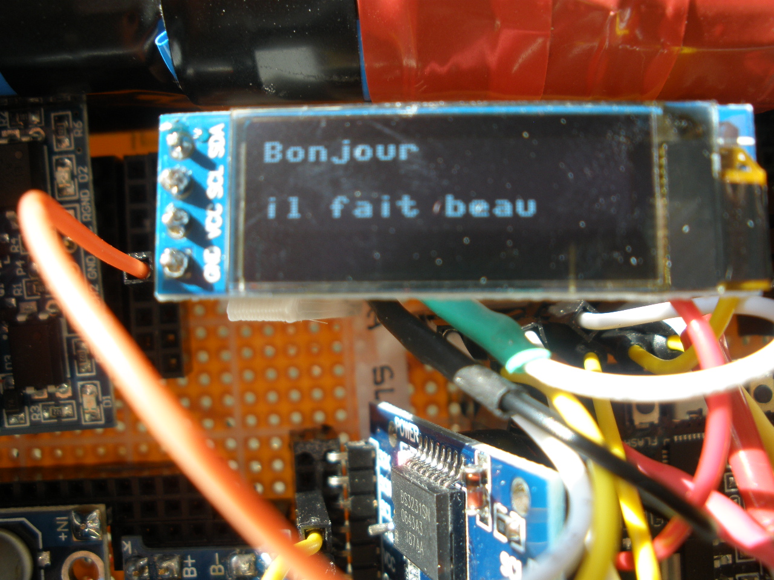
Images/PQP vue4.JPG
