CREPP-PLOEMEUR/le_Pot_Qui_pense/Images/Vidange du PQP/Vidange 2.JPG

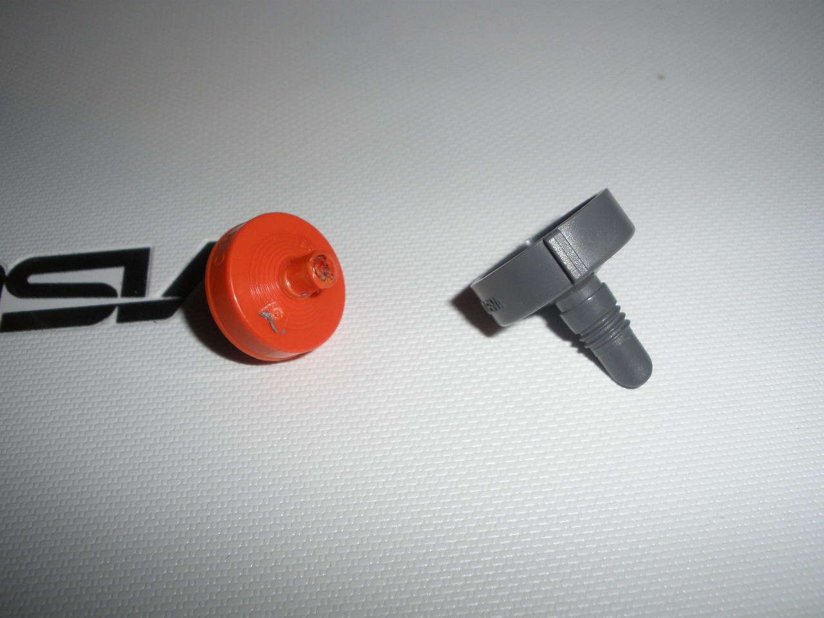
Images/Vidange du PQP/Vidange 2.JPG
