CREPP-PLOEMEUR/le_Pot_Qui_pense/Images/Vidange du PQP/Vidange 4.JPG

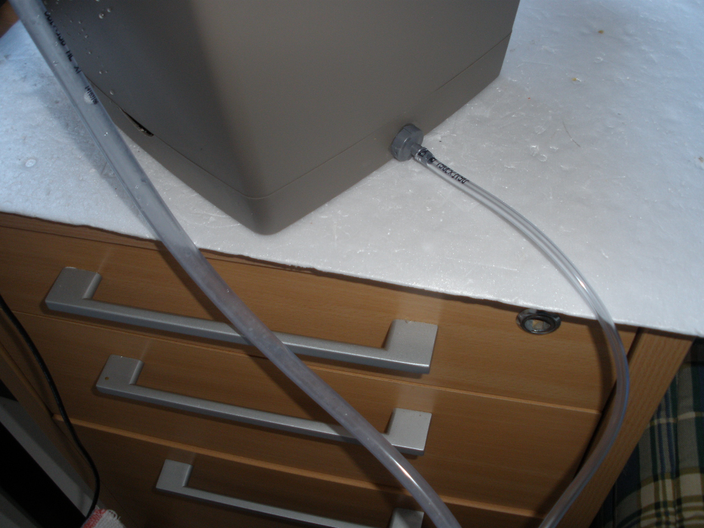
Images/Vidange du PQP/Vidange 4.JPG
