CREPP-PLOEMEUR/le_Pot_Qui_pense/Images/Vue de dessus carte mère.jpg

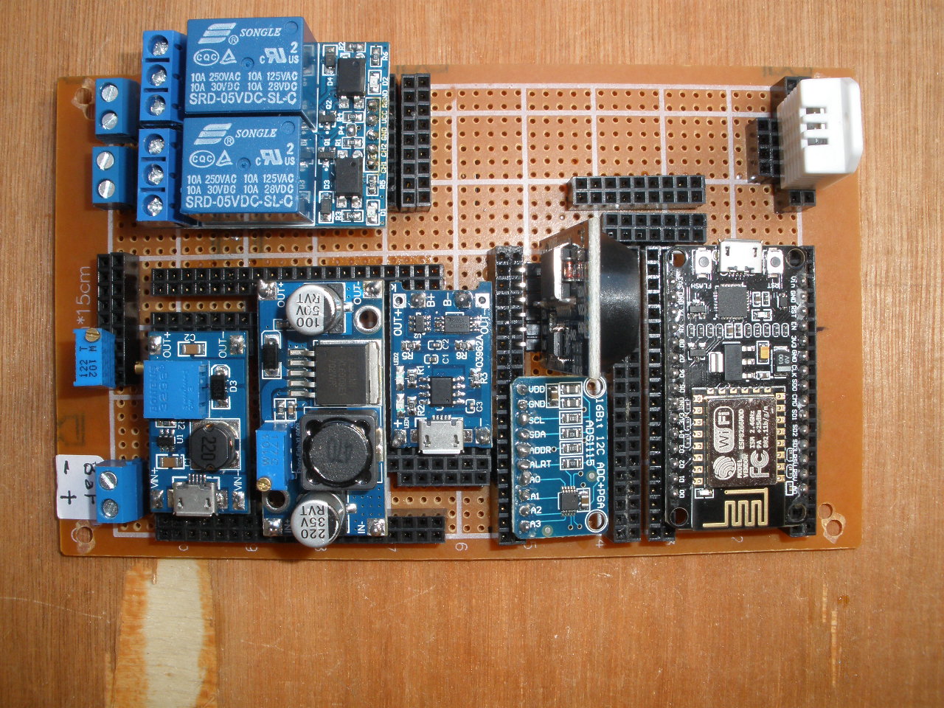
Images/Vue de dessus carte mère.jpg
