CREPP-PLOEMEUR/le_Pot_Qui_pense/Images/Vues du plant tomates cerises 1/Plant  tomates cerises vues feuilles sommet.JPG

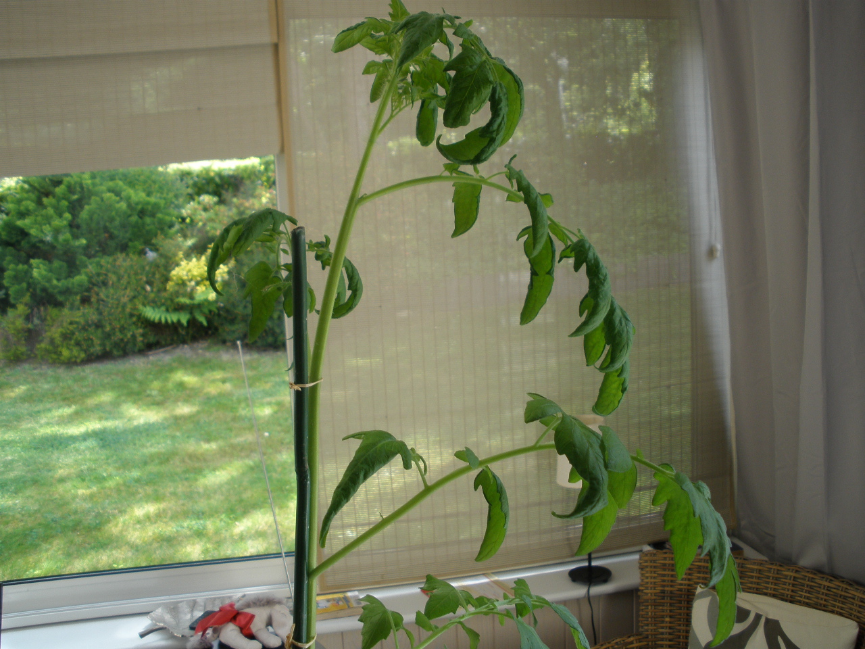
Images/Vues du plant tomates cerises 1/Plant tomates cerises vues feuilles sommet.JPG
