CREPP-PLOEMEUR/le_Pot_Qui_pense/Images/Vues du plant tomates cerises 1/Plant tomates cerises vue fleurs.JPG

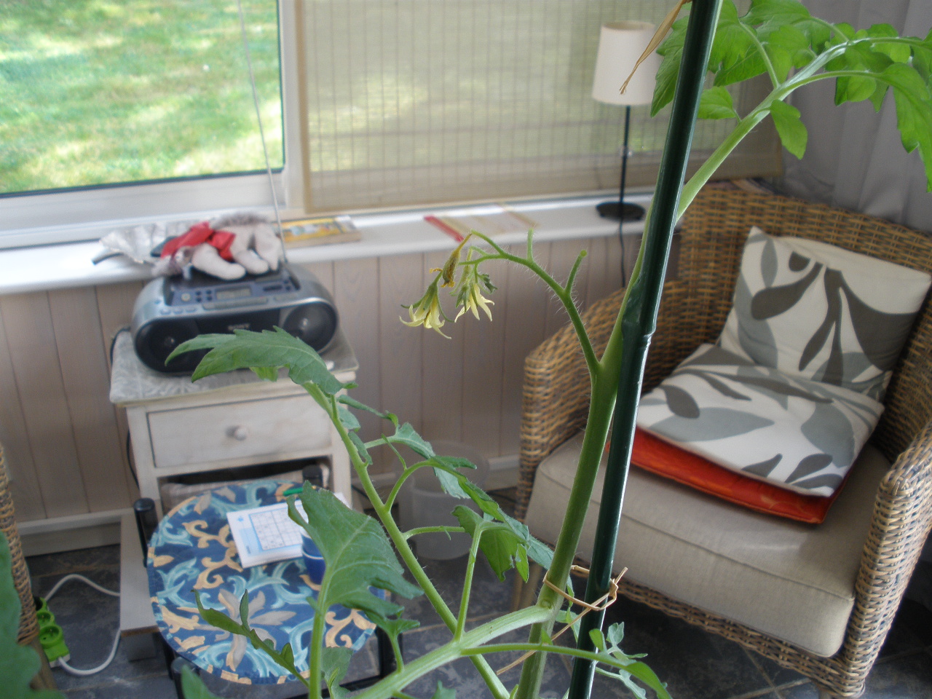
Images/Vues du plant tomates cerises 1/Plant tomates cerises vue fleurs.JPG
