CREPP-PLOEMEUR/le_Pot_Qui_pense/Fichiers STL/Molette_PotSolaire.stl

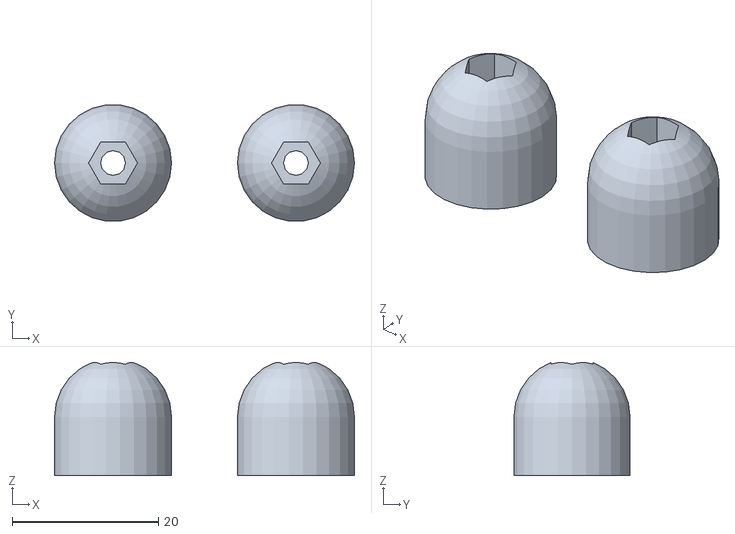
[picture p63: CAD file, 2022-04-02]
Fichiers STL/Molette_PotSolaire.stl
41.0 x 15.9 x 15.4
