CREPP-PLOEMEUR/le_Pot_Qui_pense/Fichiers STL/Pqp_BoiteCadre_sup.stl

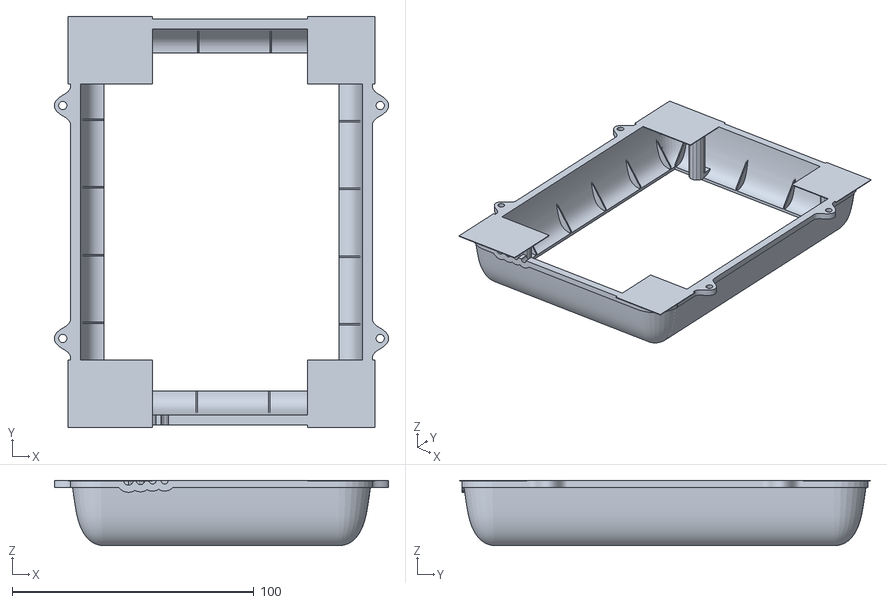
[picture p64: CAD file, 2022-04-02]
Fichiers STL/Pqp_BoiteCadre_sup.stl
138.3 x 170.0 x 27.0
