CREPP-PLOEMEUR/le_Pot_Qui_pense/Fichiers STL/Pqp_LiaisonDArrosage.stl

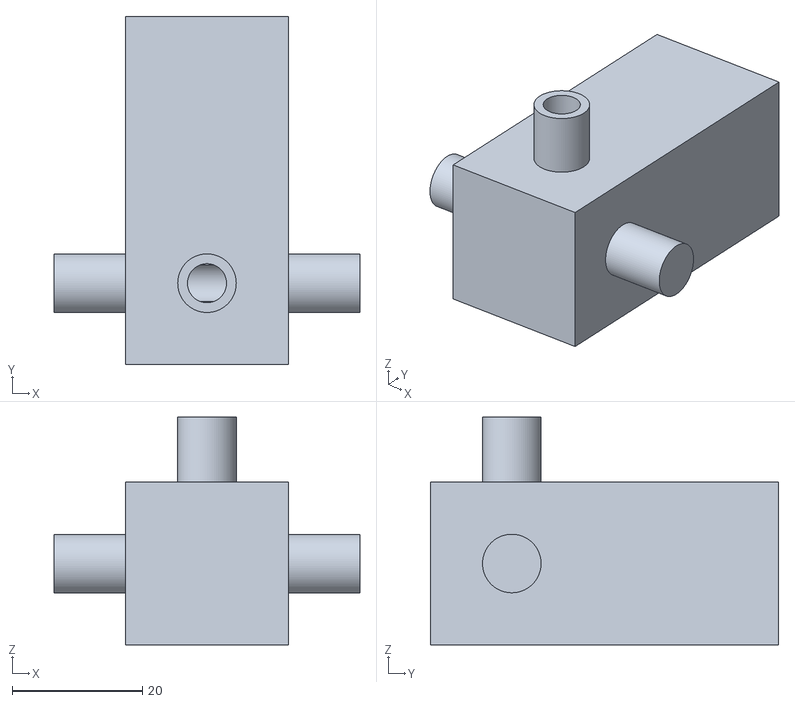
[picture p65: CAD file, 2022-04-02]
Fichiers STL/Pqp_LiaisonDArrosage.stl
47.0 x 53.5 x 35.0
