CREPP-PLOEMEUR/le_Pot_Qui_pense/Fichiers STL/Pqp_BarreBatteries.stl

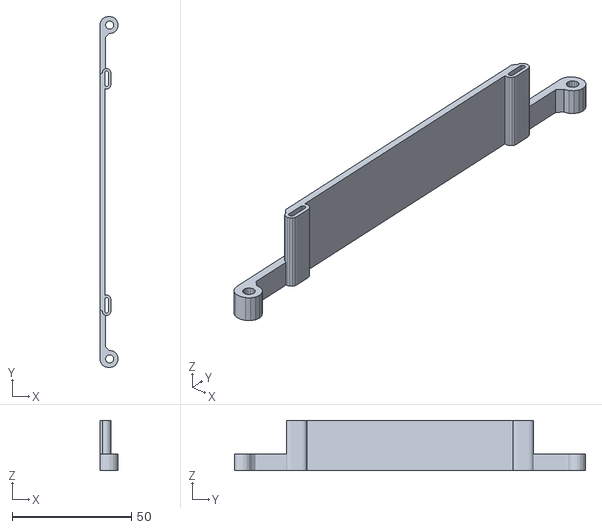
[picture p66: CAD file, 2022-04-02]
Fichiers STL/Pqp_BarreBatteries.stl
7.72 x 147.2 x 21.0
