CREPP-PLOEMEUR/le_Pot_Qui_pense/Fichiers STL/Disque capteur humidité2.stl

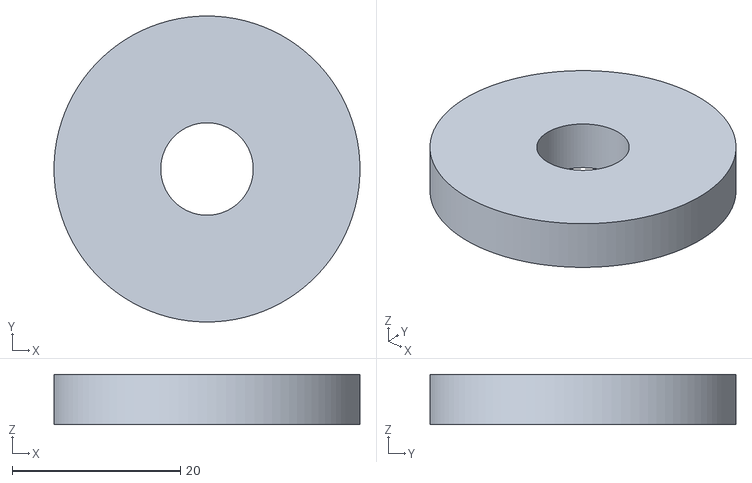
[picture p67: CAD file, 2022-04-02]
Fichiers STL/Disque capteur humidité2.stl
36.4 x 36.4 x 6.00
