CREPP-PLOEMEUR/le_Pot_Qui_pense/Fichiers STL/PotPV_n2.stl

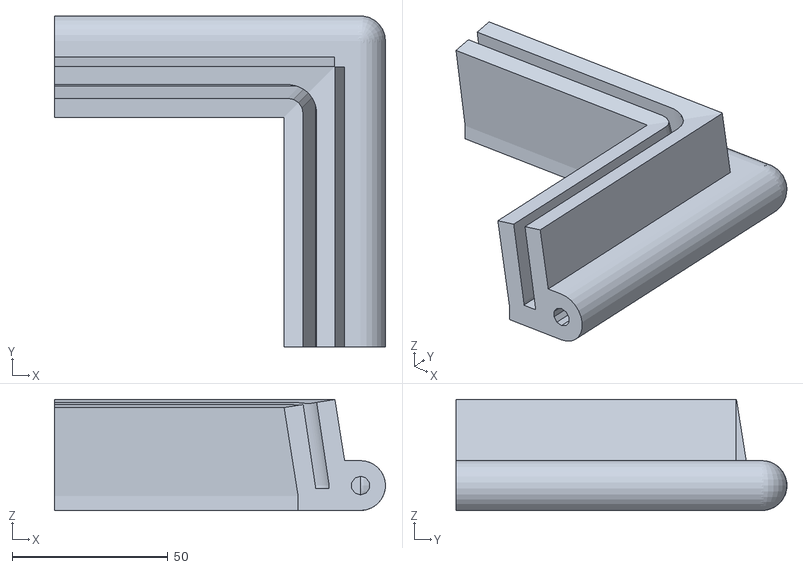
[picture p68: CAD file, 2022-04-02]
Fichiers STL/PotPV_n2.stl
106.1 x 106.0 x 35.6
