CREPP-PLOEMEUR/le_Pot_Qui_pense/Fichiers STL/PotSolaire_n3.stl

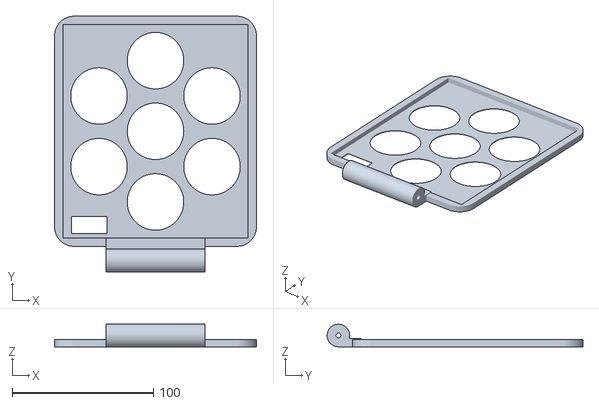
[picture p69: CAD file, 2022-04-02]
Fichiers STL/PotSolaire_n3.stl
143.0 x 181.0 x 16.0
