CREPP-PLOEMEUR/le_Pot_Qui_pense/Fichiers STL/Pqp_GriffePourLiaisonDArrosage.stl

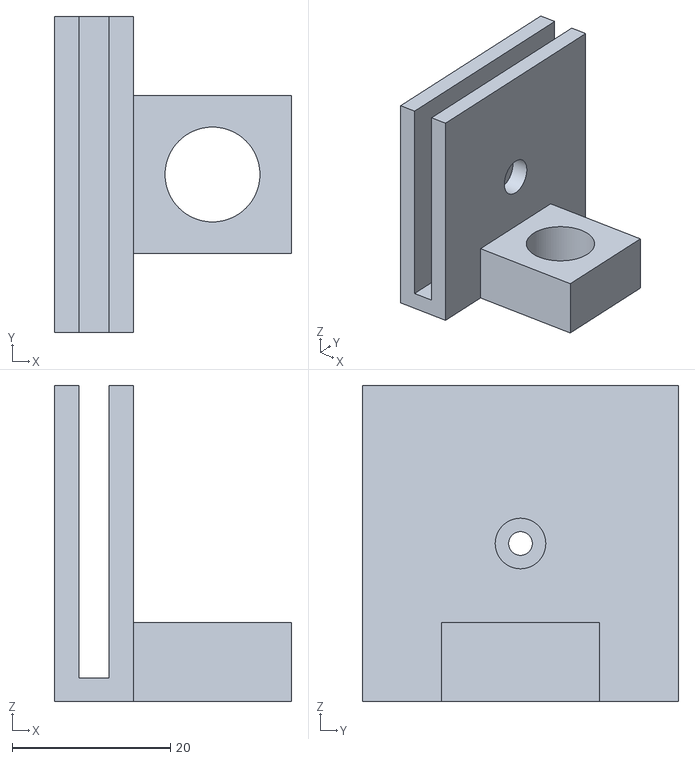
[picture p70: CAD file, 2022-04-02]
Fichiers STL/Pqp_GriffePourLiaisonDArrosage.stl
30.0 x 40.0 x 40.0
