CREPP-PLOEMEUR/le_Pot_Qui_pense/Fichiers STL/Pqp Support simple pour Solar Pot 1.stl

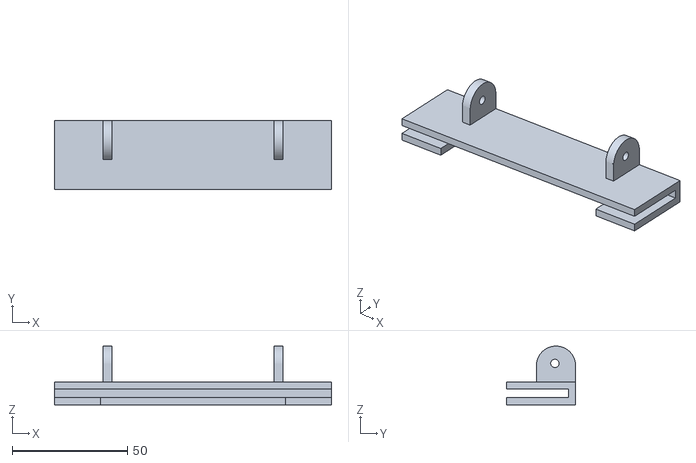
[picture p71: CAD file, 2022-04-02]
Fichiers STL/Pqp Support simple pour Solar Pot 1.stl
120.0 x 30.0 x 25.5
