CREPP-PLOEMEUR/le_Pot_Qui_pense/Fichiers STL/PotSolaire_n1.stl

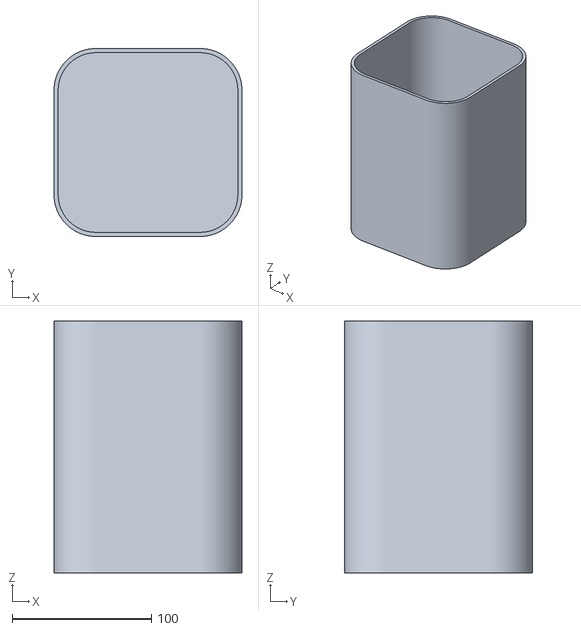
[picture p72: CAD file, 2022-04-02]
Fichiers STL/PotSolaire_n1.stl
135.0 x 135.0 x 181.0
