CREPP-PLOEMEUR/le_Pot_Qui_pense/Fichiers STL/Pqp_BoiteCadre_inf.stl

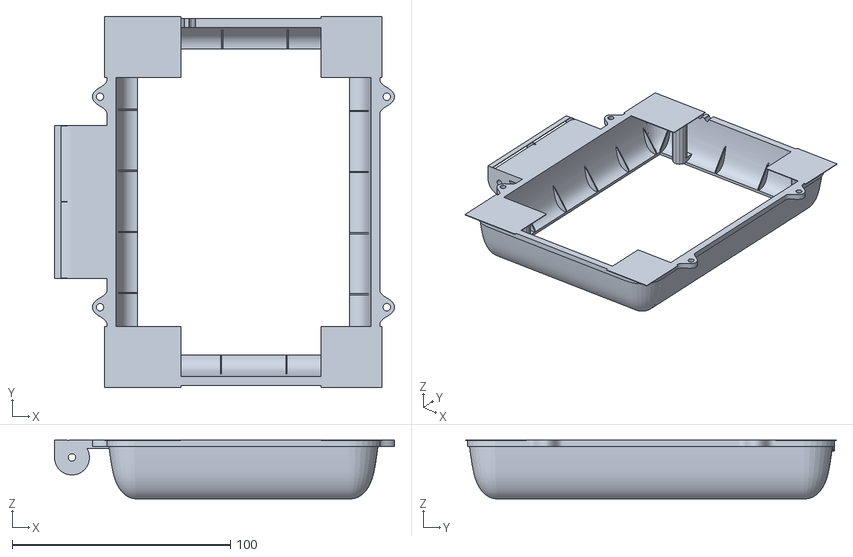
[picture p73: CAD file, 2022-04-02]
Fichiers STL/Pqp_BoiteCadre_inf.stl
155.7 x 170.0 x 27.0
