CREPP-PLOEMEUR/le_Pot_Qui_pense/Fichiers STL/Disque capteur humidité.scad

difference() {
cylinder(r=18.2,h=6,center=true, $fn=100);
    cube([24,1.26,10], center=true);
    
    
}
