CREPP-PLOEMEUR/le_Pot_Qui_pense/Fichiers STL/Disque capteur humidité2.scad

difference() {
cylinder(r=18.2,h=6,center=true, $fn=100);
    cylinder(r=5.5,h=10, center=true,$fn=80);
    
    
}
