CREPP-PLOEMEUR/le_Pot_Qui_pense/Divers/Raccordements capteur de luminosité et step up alim. ESP.PDF

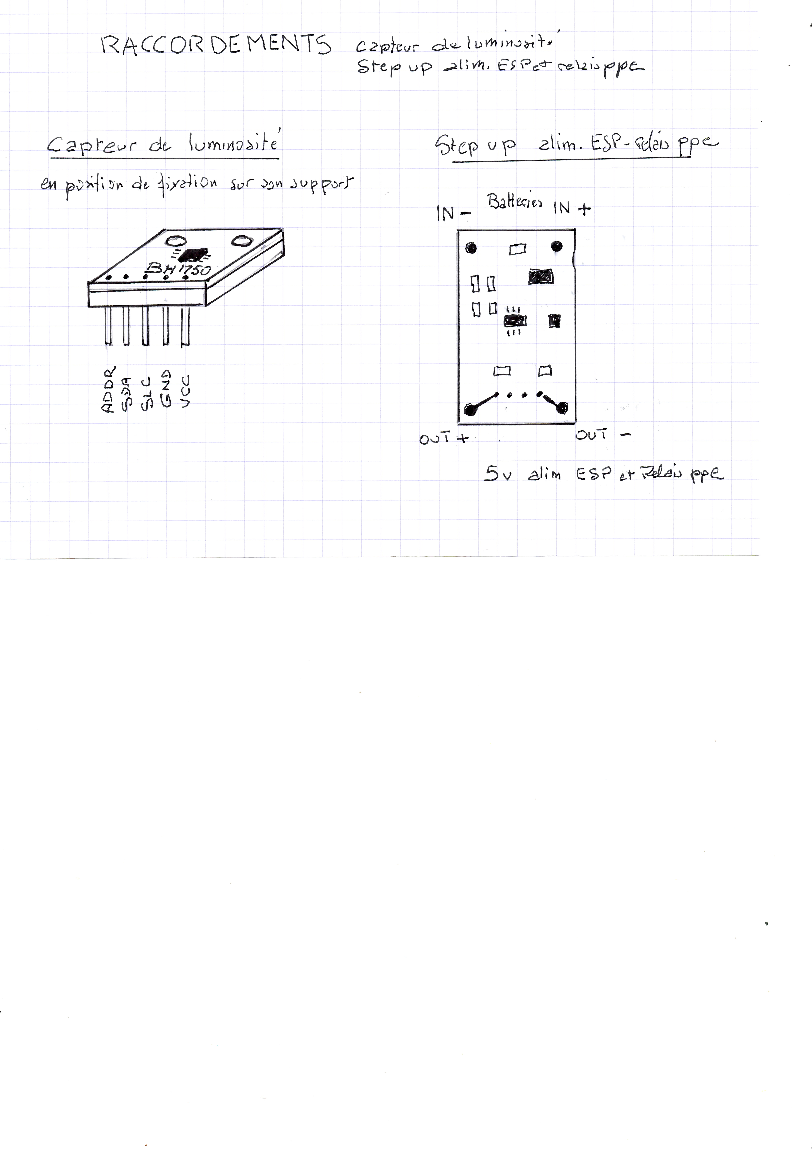
[picture p87: page 1]
