CREPP-PLOEMEUR/le_Pot_Qui_pense/Instructions/Crepp_global_2.PDF

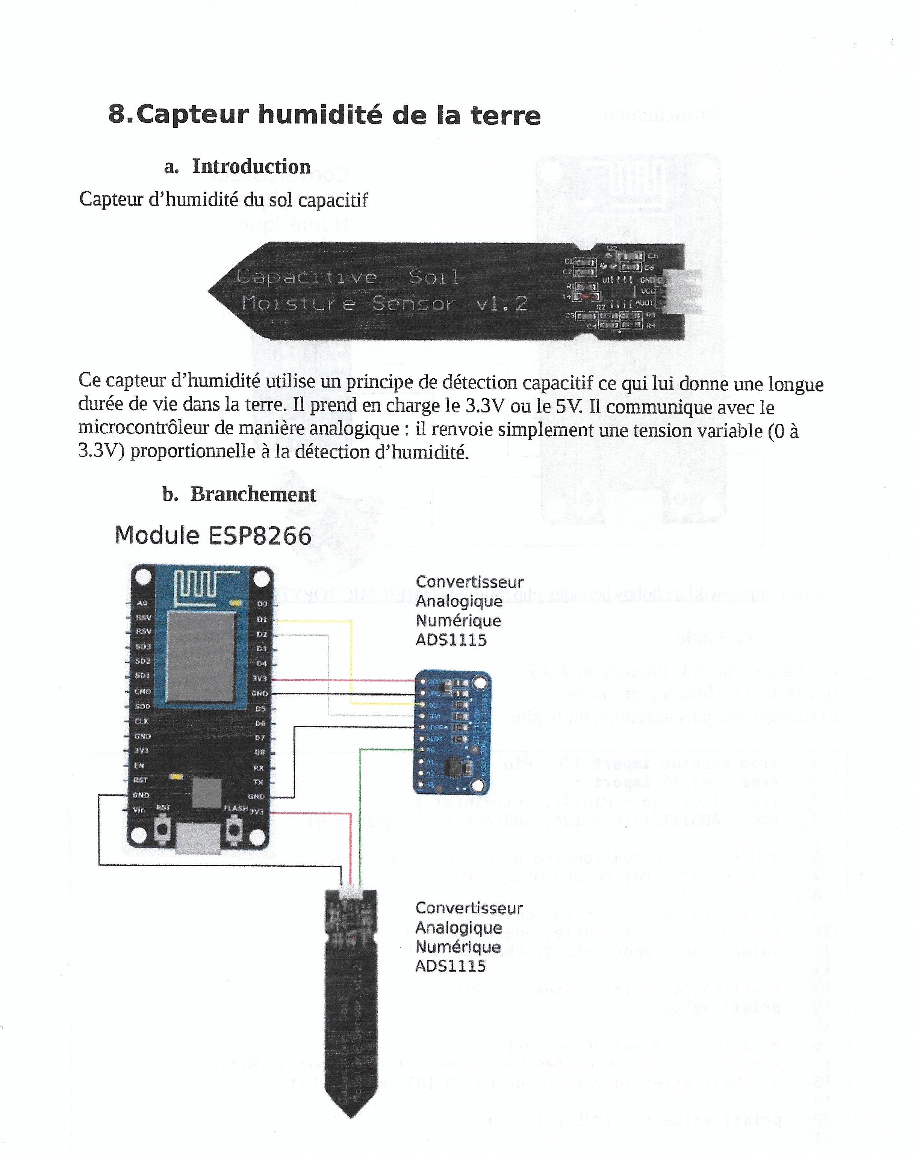
[picture p88: page 1]
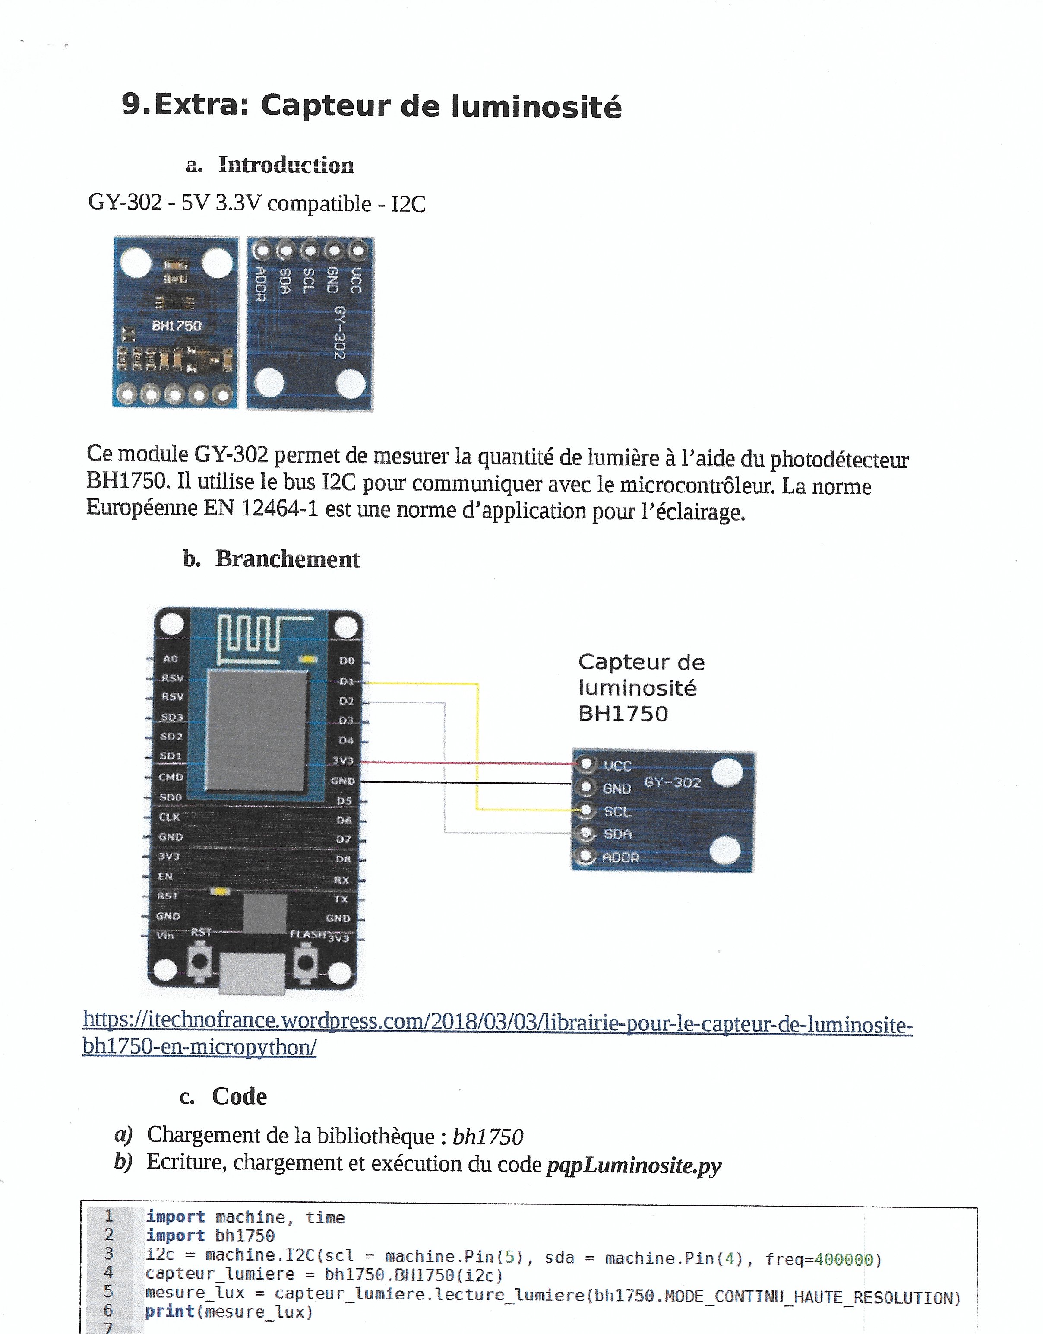
[picture p89: page 2]
