CREPP-PLOEMEUR/le_Pot_Qui_pense/Instructions/Tutoriel_Micro_Python.pdf

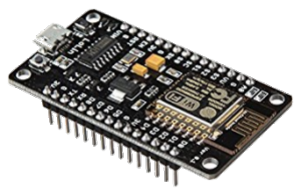
[picture p90: figure]

# Tutoriel ESP8266

Configuration et mise en place de l’ESP8266 pour une utilisation avec WebRepl

Nicolas LE GUERROUE

août 2020

Tutoriel ESP8266 | TABLE DES MATIÈRES

# Table des matières

I | Préambule | 3
1 Introduction | 4
2 Prérequis | 5
II | Installation pour Linux | 7

### 3 Effacer la mémoire

| de l’ESP8266 | 8

### 4 Installer le firmware sur

l’ESP8266 | 11

### 5 Configurer le mot de passe

WebRepl | 14
Nicolas LE GUERROUE | 1/18

Tutoriel ESP8266 | TABLE DES MATIÈRES
Bibliographie | 17
Nicolas LE GUERROUE | 2/18

# Première partie

# Préambule

3

Tutoriel ESP8266 | CHAPITRE 1. INTRODUCTION

# Chapitre 1

# Introduction

## 1.1 Présentation

Ce document a pour but de configurer un ESP8266-12E (NodeMCU) afin que ce dernier puisse être accessible en tant que réseau Wifi.
Ce tutoriel s’adresse également dans le cas où vous avez perdu vos mots de passe d’accès (réseau wifi ou WebRepl) ou bien que vous souhaitez partir sur des bases saines.

Information

Le temps estimé pour réaliser ce tutoriel est de 25 min

## 1.2 Conventions

Les commandes à saisir sont dans des encadrés similaires :

sudo apt-get update

Exemple de commande

Nicolas LE GUERROUE | 4/18

Tutoriel ESP8266 | CHAPITRE 2. PRÉREQUIS

# Chapitre 2

# Prérequis

## 2.1 Matériel

Pour réaliser ce tutoriel, vous aurez besoin de

- Un ordinateur (Linux, Apple ou Windows)
- Un ESP8266-12E (NodeMCU)
- Un cable USB Micro Type-B

## 2.2 Mise à jour des systèmes UNIX

Avant toute chose, il convient de mettre à jour la liste des paquets et de mettre à jour les logiciels déjà présents sur votre ordinateur si ce dernier est sous LINUX (UNIX).
Les commandes suivantes sont à saisir dans un terminal.

### 2.2.1 Mise à jour de la liste des paquets

sudo apt-get update

Mise à jour de la liste des paquets

puis

Nicolas LE GUERROUE | 5/18

Tutoriel ESP8266 | CHAPITRE 2. PRÉREQUIS

### 2.2.2 Mise à jour des logiciels

sudo apt-get -y upgrade

| Mise à jour des logiciels

Le -y sert à accepter automatiquement la mise à jour.

### 2.2.3 Mise à jour de Python

Il conviendra d’installer au minimum la version 3.6 de Python. Pour vérifier votre version, ouvrez un terminal et saisissez la commande

python3

| Vérification de la version de python

Si l’invité de commande Python suivant apparaît, la version est présente.

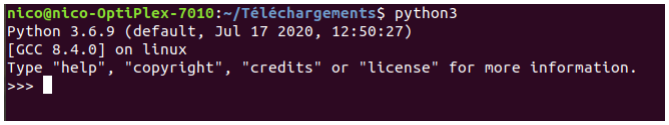
[picture p91: figure]

Figure 2.1 – Invité de commande Python

Le cas échéant, je vous invite à saisir la commande suivante :

sudo apt-get -y install python3.7

Installation de Python 3.7

Nicolas LE GUERROUE | 6/18

# Deuxième partie

# Installation pour Linux

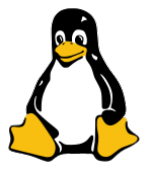
[picture p92: figure]

7

Tutoriel ESP8266

CHAPITRE 3. EFFACER LA MÉMOIRE DE L’ESP8266

# Chapitre 3

# Effacer la mémoire de l’ESP8266

Dans un premier temps, nous allons effacer le contenu de la puce ESP8266. Ceci nous permettra de partir sur des bases saines.

Point-clé

Maintenant, vous pouvez brancher votre ESP8266 sur un des ports USB de votre ordinateur.

Il convient ensuite d’installer les outils adéquats.

## 3.1 Installation de Pip3

Pip3 est un utilitaire Python qui va nous permettre d’installer le petit programme pour effacer l’ESP8266.
On l’installe de la manière suivante :

sudo apt-get -y install python3-pip

Installation de Pip3

## 3.2 Installation de Esptool

L’utilitaire qui va se charger d’exécuter cette opération s’appelle esptool . Pour l’installer, on effectue

Nicolas LE GUERROUE | 8/18

Tutoriel ESP8266

CHAPITRE 3. EFFACER LA MÉMOIRE DE L’ESP8266

pip3 install esptool

Installation de Esptool

Voici le résultat de la commande sur le terminal :

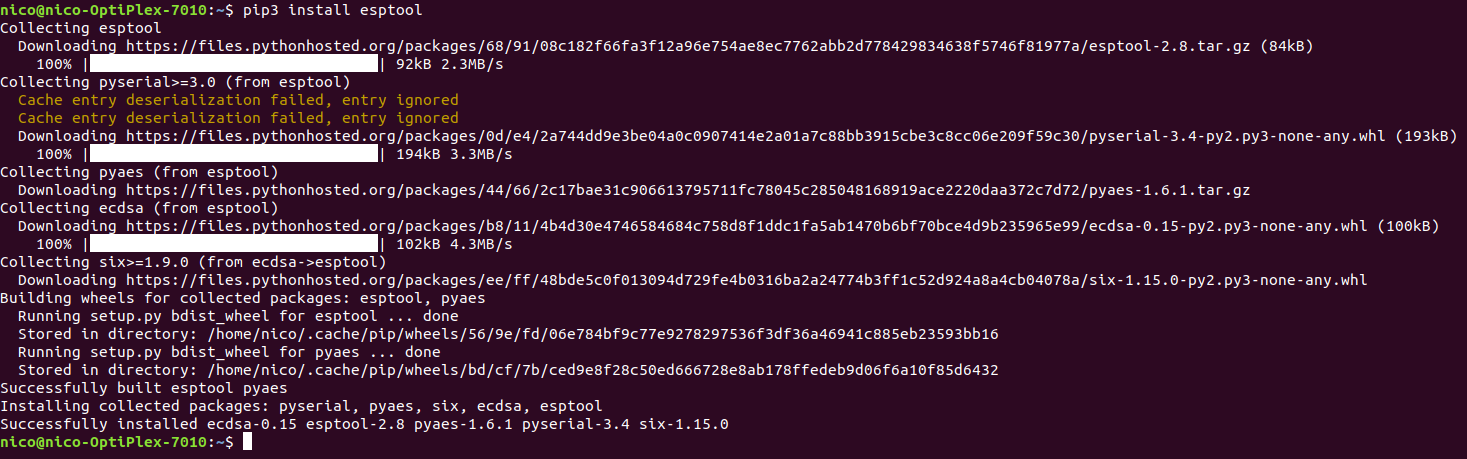
[picture p93: figure]

Figure 3.1 – Résultat de l’installation de pip3

## 3.3 Récupération du port USB

L’ESP8266 étant raccordé, l’ordinateur lui a affecté un nom de port de type /dev/ttyUSBx avec x représentant le numéro du périphérique USB.

Pour récupérer la valeur de ce numéro, nous allons lancer la commande suivante :

esptool.py flash_id

Récupération du numéro du port série

Figure 3.2 – Résultat de la commande esptool.py flash_id

Dans le cas présent,le nom du port est /dev/ttyUSB0

## 3.4 Effacer la mémoire

Lancer la commande suivante :

Nicolas LE GUERROUE | 9/18

Tutoriel ESP8266

CHAPITRE 3. EFFACER LA MÉMOIRE DE L’ESP8266

esptool.py --port /dev/ttyUSB0 erase_flash

Effacer la mémoire de l’ESP8266

Évidemment, si vous avez un autre numéro de port avec la commande lsusb, vous mettez votre numéro.
Voici le résultat de la commande sur le terminal :

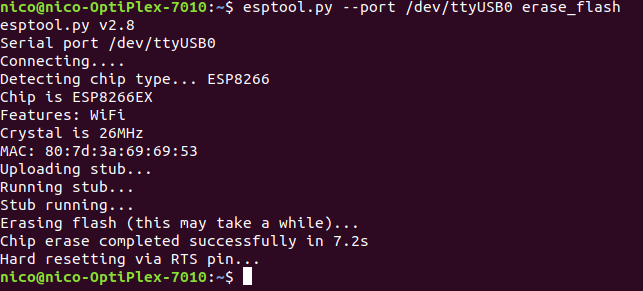
[picture p94: figure]

Figure 3.3 – Résultat de la commande pour effacer l’ESP8266

Nicolas LE GUERROUE | 10/18

Tutoriel ESP8266

CHAPITRE 4. INSTALLER LE FIRMWARE SUR L’ESP8266

# Chapitre 4

# Installer le firmware sur l’ESP8266

Maintenant que l’ESP8266 est vide, il nous reste à installer son logiciel (firmware) fin qu’il puisse utiliser le Wifi selon deux mode :

- Point d’accès : l’ESP8266 créer son propre réseau Wifi
- Connexion : l’ESP8266 peut se connecter à un réseau Wifi pour dialo-guer

## 4.1 Récupération du logiciel

Le logiciel se présente sous fichier binaire (.bin) et est disponible à l’adresse suivante :

http://micropython.org/download/esp8266/

Je vous invite à télécharger la dernière version stable (latest)

Nicolas LE GUERROUE | 11/18

Tutoriel ESP8266

CHAPITRE 4. INSTALLER LE FIRMWARE SUR L’ESP8266

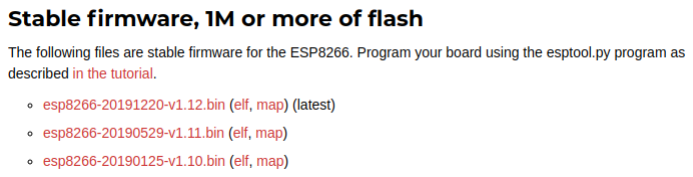
[picture p95: figure]

Figure 4.1 – Récupération du logiciel pour l’ESP8266

## 4.2 Installation du logiciel

Tout d’abord, placer vous dans le même répertoire que votre fichier binaire installé précédemment et ouvrez un terminal.

La commande ls devrait confirmer votre contenu du répertoire.

ls

Vérification du répertoire

Figure 4.2 – Contenu du répertoire

Il ne vous reste plus qu’a saisir la commande pour installer le firmware.

esptool.py --port /dev/ttyUSB0 --baud 460800 write_flash --flash_size=detect 0 esp8266-20190125-v1.10.bin

Installation du firmware

Comme précédemment, si vous avez un nom de fichier différent, je vous laisse le soin de changer de nom afin de coïncider avec le vôtre.

Nicolas LE GUERROUE | 12/18

Tutoriel ESP8266

CHAPITRE 4. INSTALLER LE FIRMWARE SUR L’ESP8266

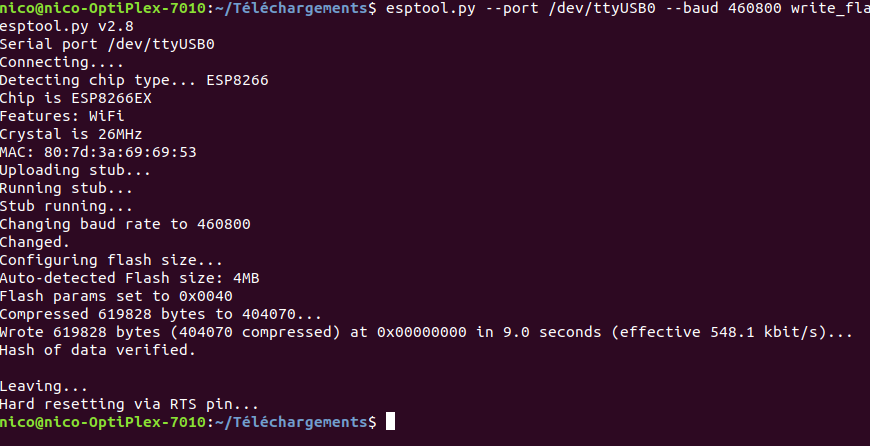
[picture p96: figure]

Figure 4.3 – Résultat de la commande pour installer le firmware

Après le déploiement du firmware, le module redémarre et il est configuré en point d’accès WiFi avec pour nom MicroPython-6953.
Les chiffres correspondent aux derniers chiffres de l’adresse MAC du module.
Nicolas LE GUERROUE | 13/18

Tutoriel ESP8266

CHAPITRE 5. CONFIGURER LE MOT DE PASSE WEBREPL

# Chapitre 5

# Configurer le mot de passe WebRepl

## 5.1 Installation de WebRepl

Le logiciel WebRepl va nous permettre de se connecter à l’ESP8266 afin de saisir des commandes Python.
Le logiciel est dispoible à l’adresse suivante :

https://github.com/micropython/webrepl

Cliquez ensuite sur Code puis Download Zip

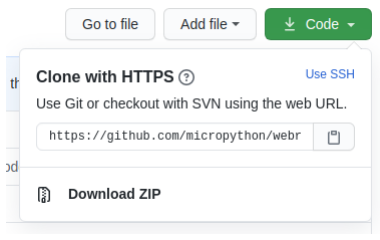
[picture p97: figure]

Figure 5.1 – Téléchargement de WebRepl sur Github

Veuillez commencer par extraire l’archive. Celle-ci contient les fichiers suivants :

Nicolas LE GUERROUE | 14/18

Tutoriel ESP8266

CHAPITRE 5. CONFIGURER LE MOT DE PASSE WEBREPL

Figure 5.2 – Contenu du dossier WebRepl

## 5.2 Installation de screen

screen est un utilitaire qui va nous permettre de se connecter à l’ESP8266 via le cable USB car actuellement, il nous est impossible d’utiliser WebRepl. On installe l’utilitaire avec la commande suivante :

sudo apt-get install -y screen

Installation de screen

## 5.3 Création du mot de passe

### 5.3.1 Utilisation de screen

On peut accéder à l’interpréteur de commande Python (REPL : Read Evaluate Print Loop) via le port série en tapant la commande suivante sous Linux :

screen /dev/ttyUSB0 115200

Execution de screen

Point-clé

Il faut appuyer sur la touche Entrée pour afficher l’invité de commande MicroPython.

Figure 5.3 – Console screen

Nicolas LE GUERROUE | 15/18

Tutoriel ESP8266

CHAPITRE 5. CONFIGURER LE MOT DE PASSE WEBREPL

Pour quitter Screen, il faut appuyer sur les touches CTRL a puis écrire :quit

Ensuite, entrez la commande suivante :

>>> import webrepl_setup

Commande pour créer un mot de passe

Le système vous demande tout d’abord d’activer l’accès par le web dès le démarrage en saisissant E.

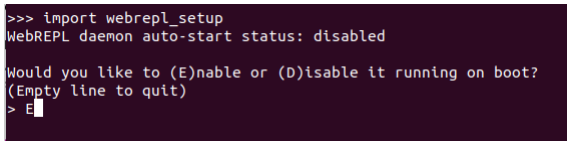
[picture p98: figure]

Figure 5.4 – Activation de l’ESP8266 screen

Il vous invite ensuite à saisir le mot de passe pour l’accès à WebRepl. Ici le mot de passe choisi est crepp

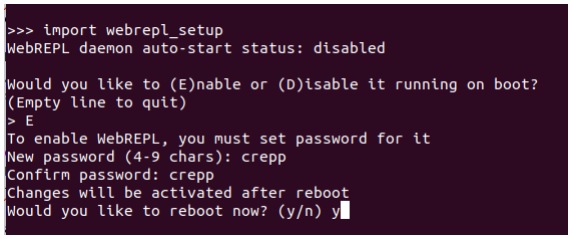
[picture p99: figure]

Figure 5.5 – Activation de l’ESP8266 screen

Enfin, saissisez y pour redémarrer l’ESP8266. A ce moment là, les lignes suivantes apparaissent :

Nicolas LE GUERROUE | 16/18

Tutoriel ESP8266

CHAPITRE 5. CONFIGURER LE MOT DE PASSE WEBREPL

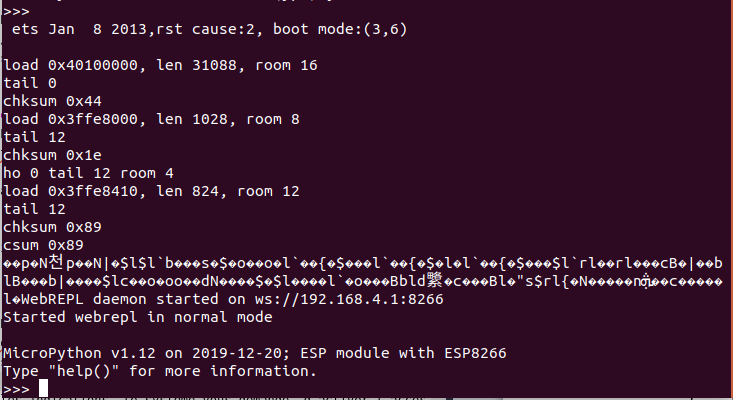
[picture p100: figure]

Figure 5.6 – Fin de la configuration

La configuration de l’ESP8266 est terminée

## 5.4 Connexion à WebRepl

### 5.4.1 Connexion au réseau de l’ESP8266

Tout d’abord, veuillez chercher parmi les réseaux Wifi le réseau de l’ESP8266 appelé MicroPython-XXXX avec XXX représentant les 4 derniers chiffres de l’adresse MAC de l’ESP8266.
Lors de la connexion, un mot de passe est demandé, saisir micropythoN

### 5.4.2 Lancement de WebRepl

Veuillez lancer le fichier ‘webrepl.html‘ dans le dossier WebRepl précédemment installé.
Vous tombez sur l’interface Web. Il suffit de cliquer sur Connect et d’entrer le mot de passe que vous avez définie. (en l’occurence crepp).
Nicolas LE GUERROUE | 17/18

Tutoriel ESP8266 | BIBLIOGRAPHIE

# Bibliographie

[1] Installation du firmware de l’ESP8266

https://docs.micropython.org/en/latest/esp8266/tutorial/intro.html#intro (https://docs.micropython.org/en/latest/esp8266/tutorial/intro.html#intro)

[2] Installation du firmware de l’ESP8266 et configuration du mot de passe

https://itechnofrance.wordpress.com/2018/02/04/installation-de-micropython-sur-nodemcu-lolin-ou-wemos-d1-mini/ (https://itechnofrance.wordpress.com/2018/02/04/installation-de-micropython-sur-nodemcu-lolin-ou-wemos-d1-mini/)

Nicolas LE GUERROUE | 18/18
