CREPP-PLOEMEUR/le_Pot_Qui_pense/Images/Step up alim ESP - relais pompe.jpeg

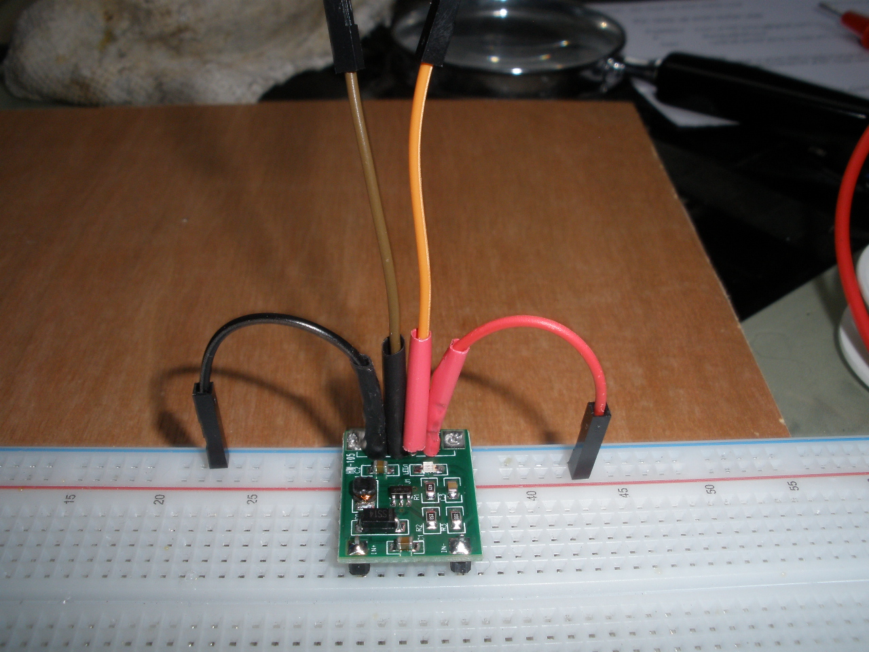
Images/Step up alim ESP - relais pompe.jpeg
