CREPP-PLOEMEUR/le_Pot_Qui_pense/Images/Vue du step up alim ESP - relais pompe.jpg

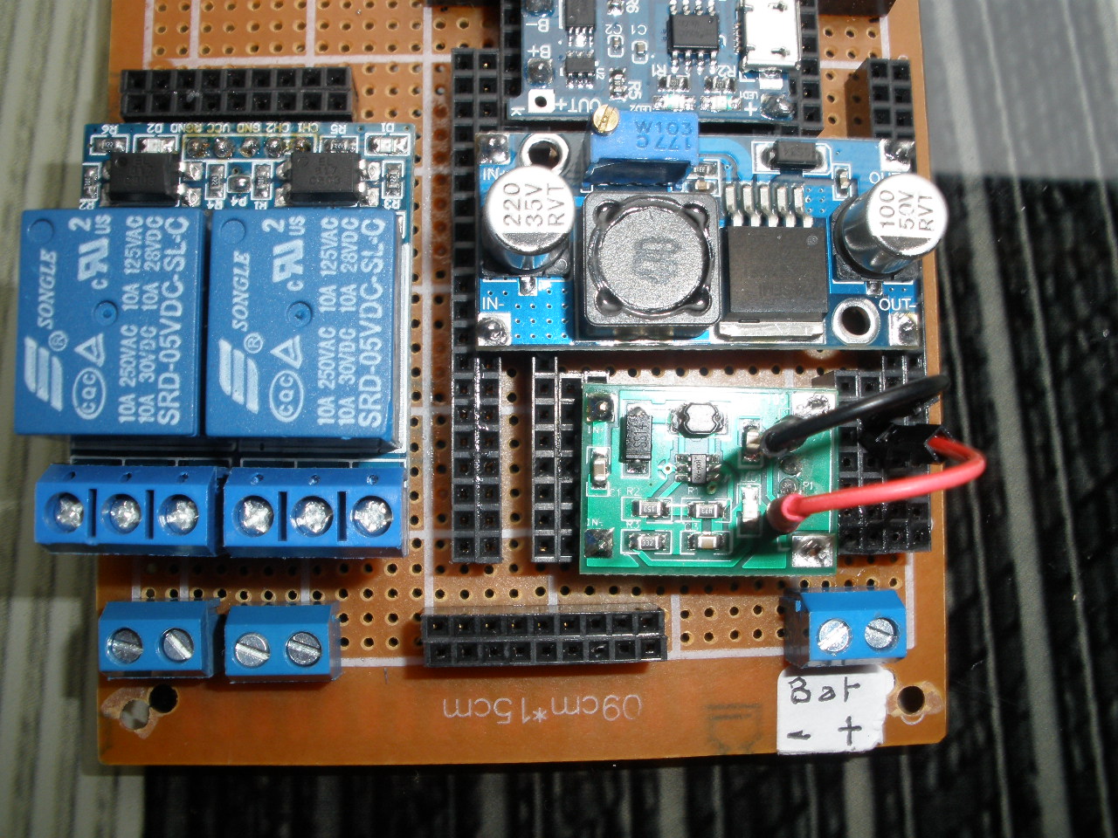
Images/Vue du step up alim ESP - relais pompe.jpg
